versioduo/sax/hardware/sax/sax.pdf

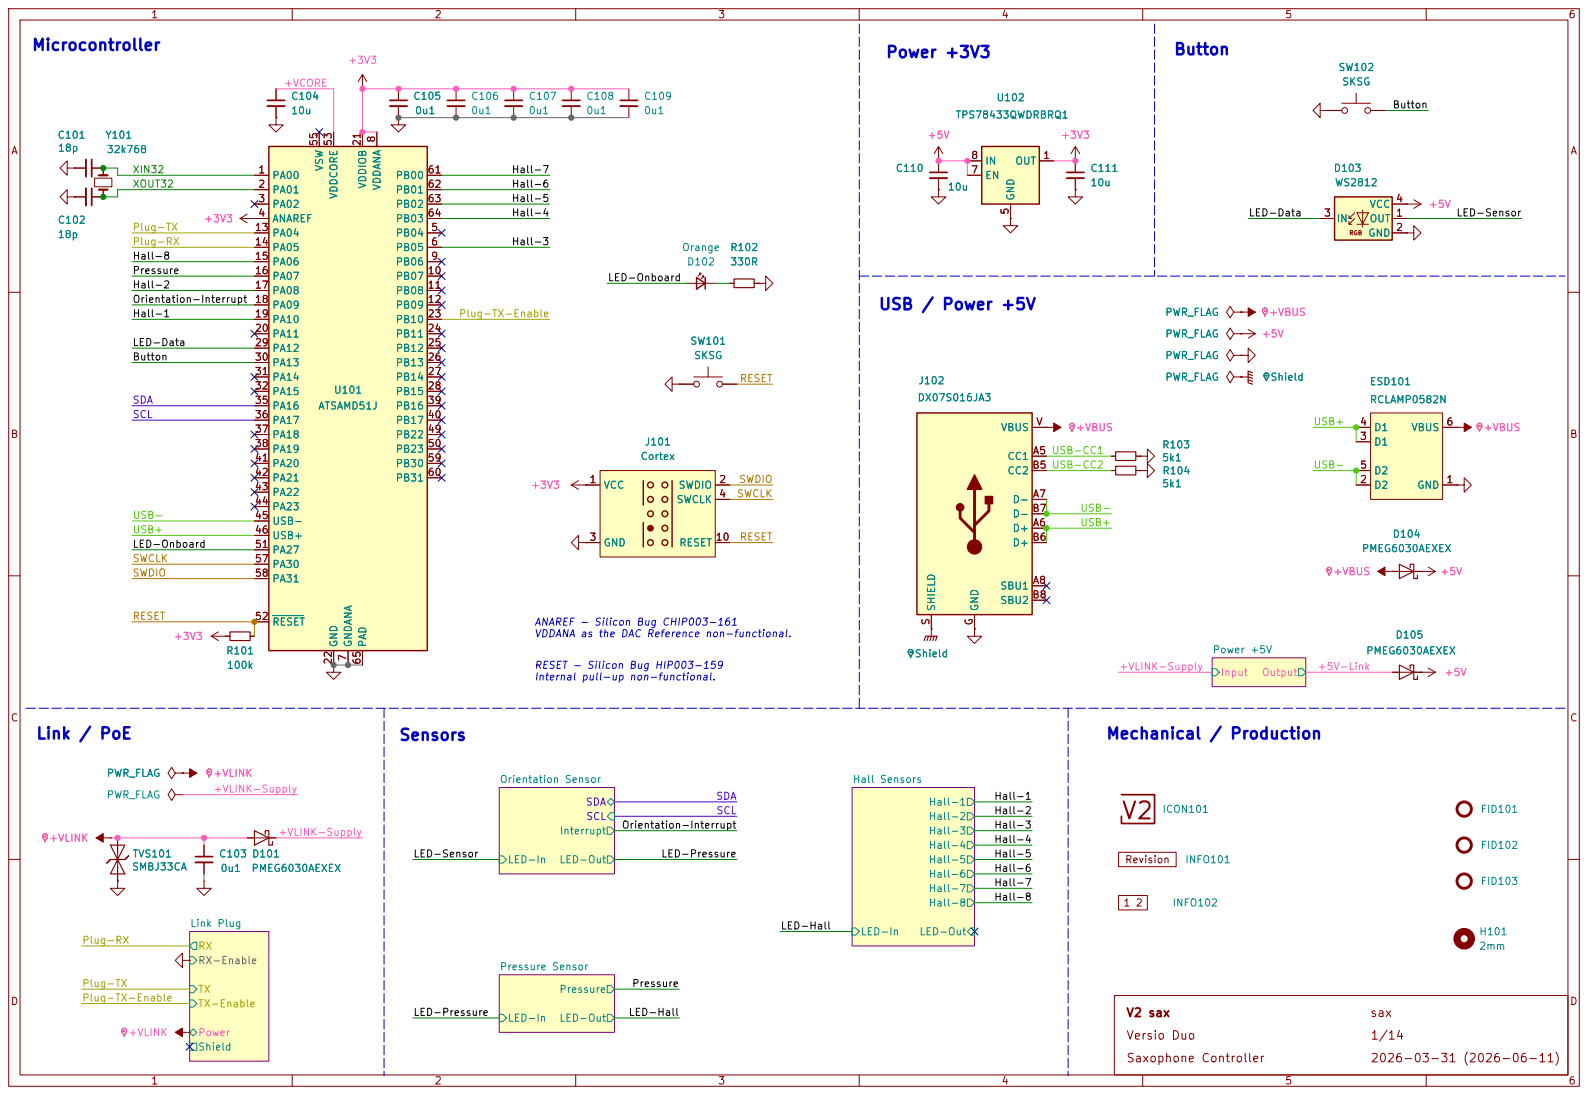
[picture p1: page 1]

LED-Data Plug-RX

VDDANA as the DAC Reference non-functional. Sensors

Internal pull-up non-functional. Link / PoE

TX-Enable Power Shield

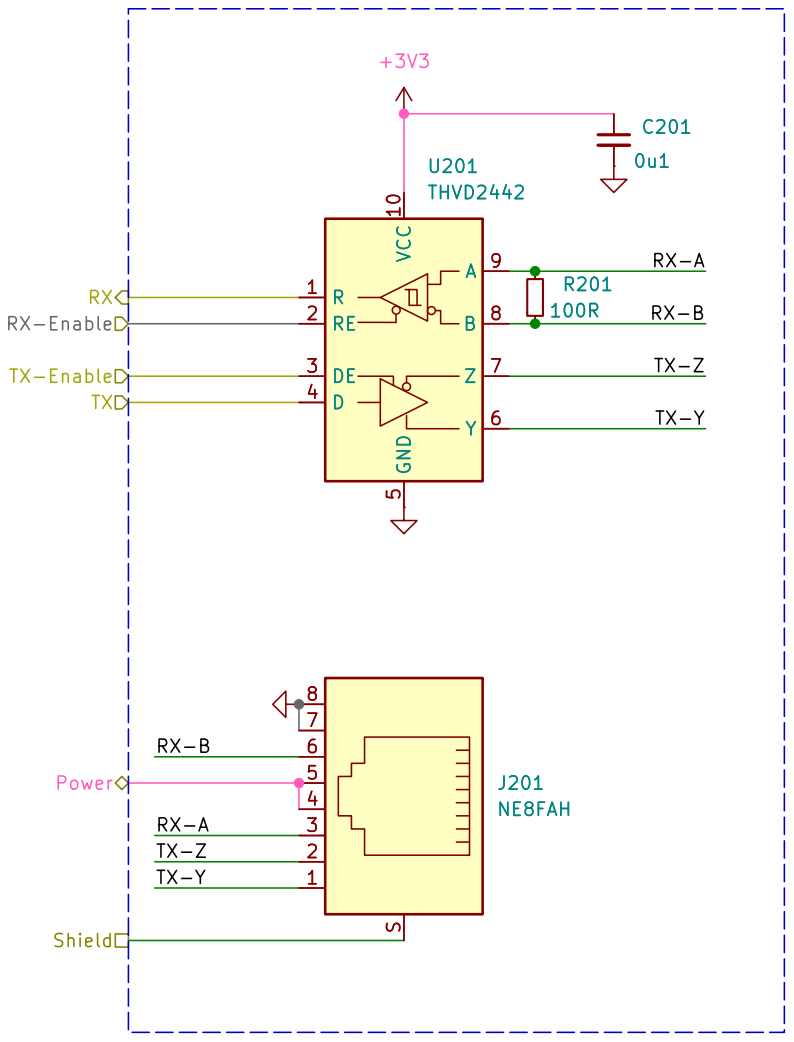
[picture p2: page 2]

0u1 RX-Enable Power TX-Enable RX

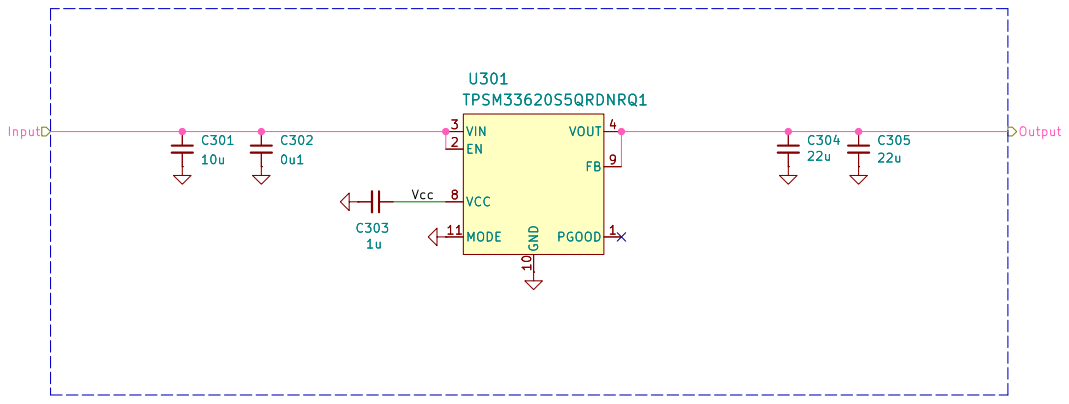
[picture p3: page 3]

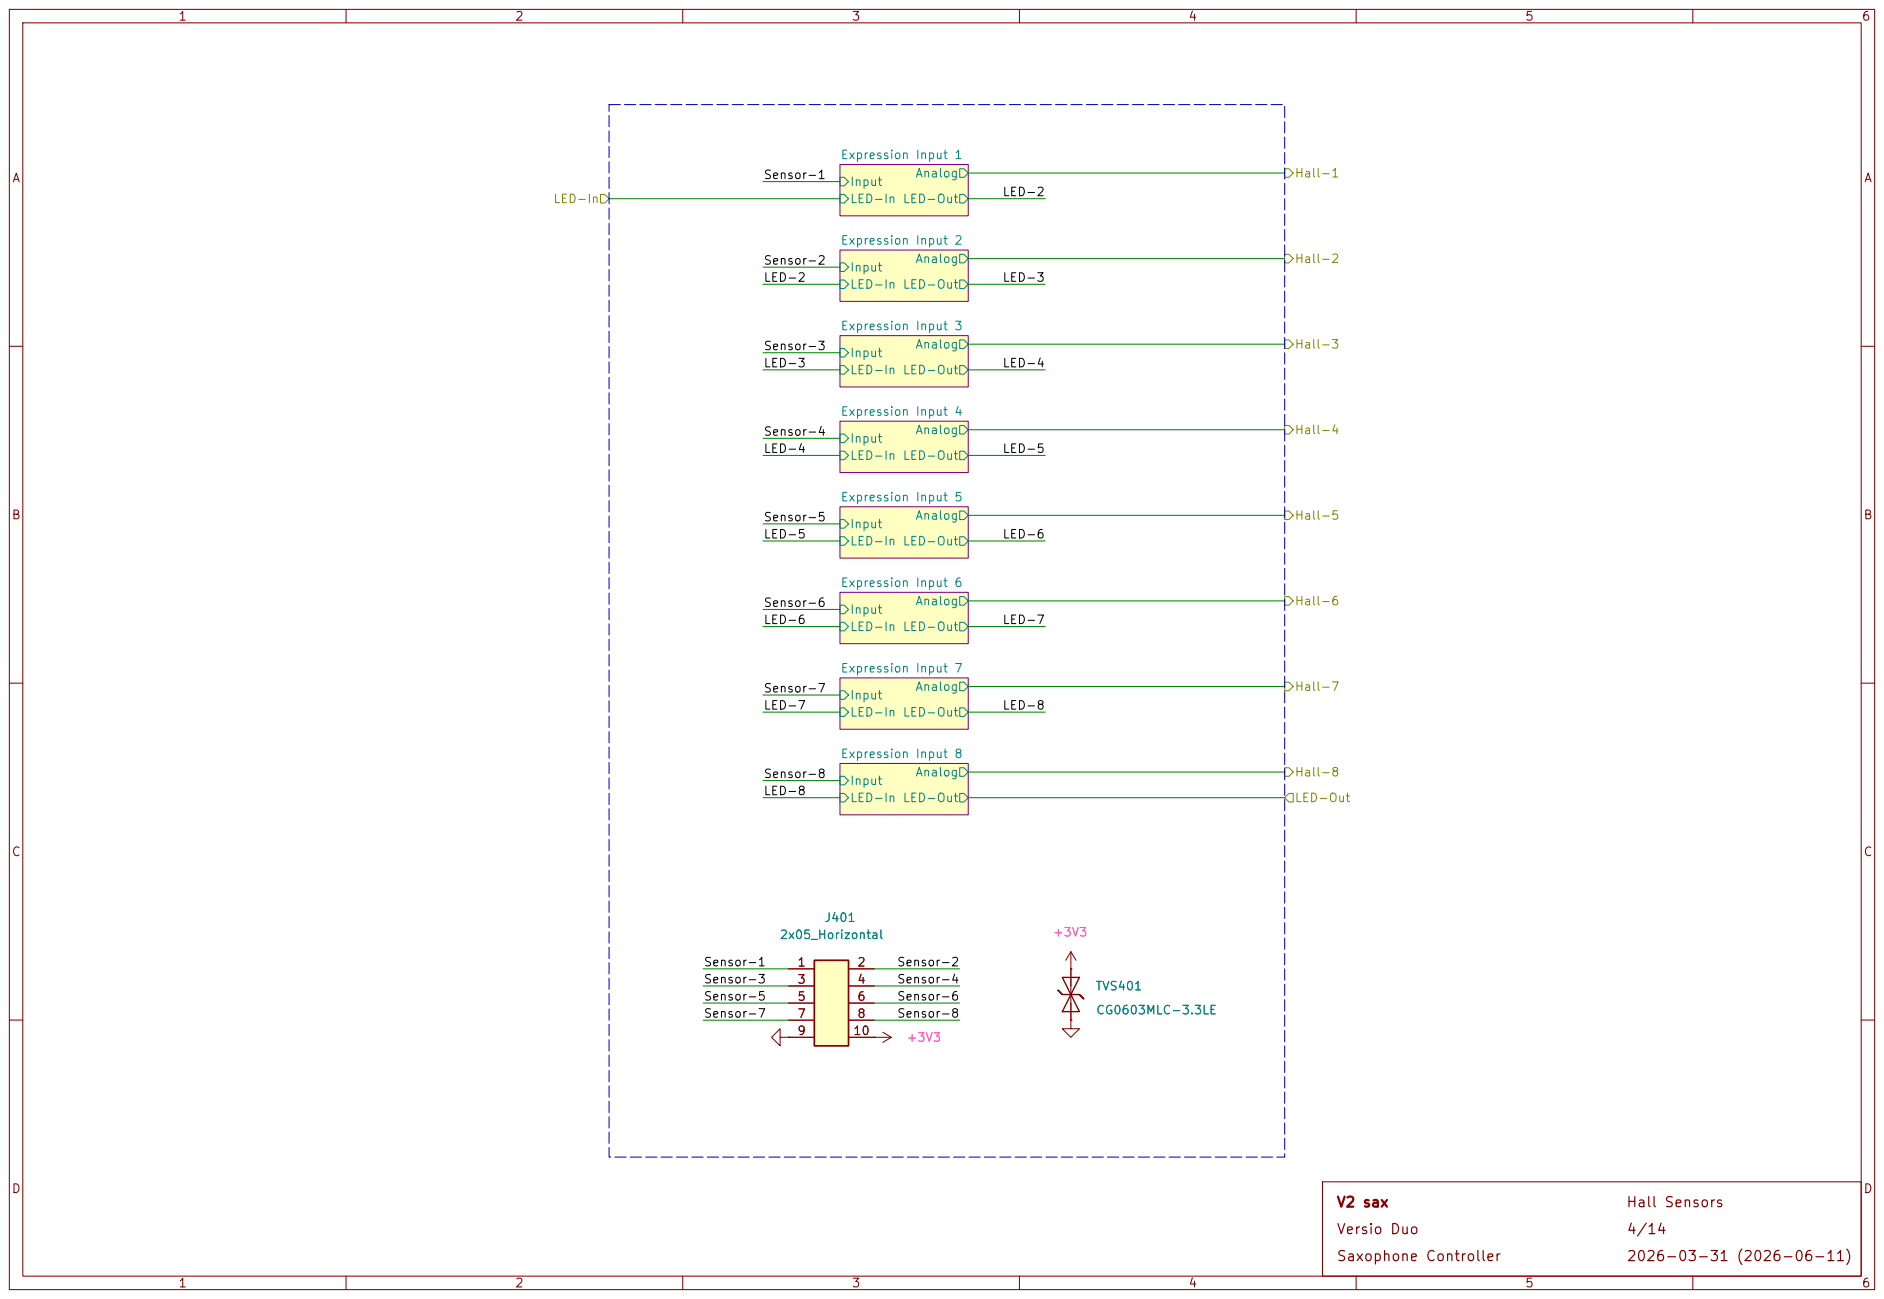
[picture p4: page 4]

Expression Input 1
LED-In LED-Out Analog Input

LED-Out Hall-8 Hall-7 Hall-2 Hall-3 Hall-1 Hall-6 Hall-5 Hall-4

Expression Input 2

Expression Input 3

Expression Input 4

Expression Input 5

Expression Input 7

Expression Input 8

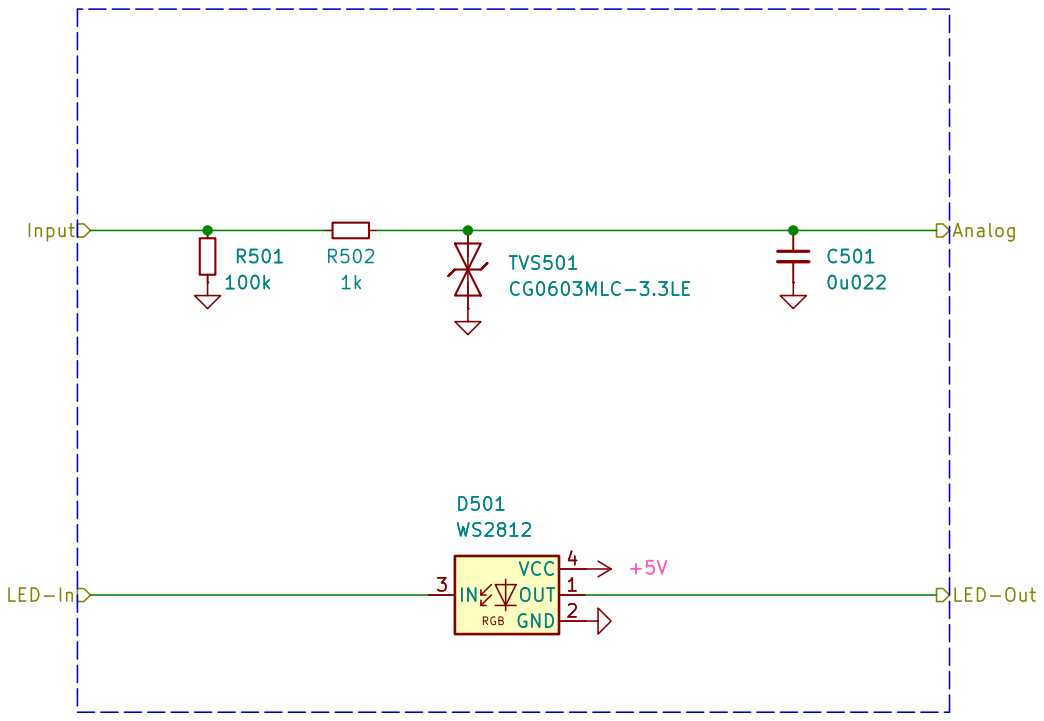
[picture p5: page 5]

TVS501 CG0603MLC-3.3LE +5V D501 WS2812OUT 1 GND 2 VCC 4 D501 WS2812

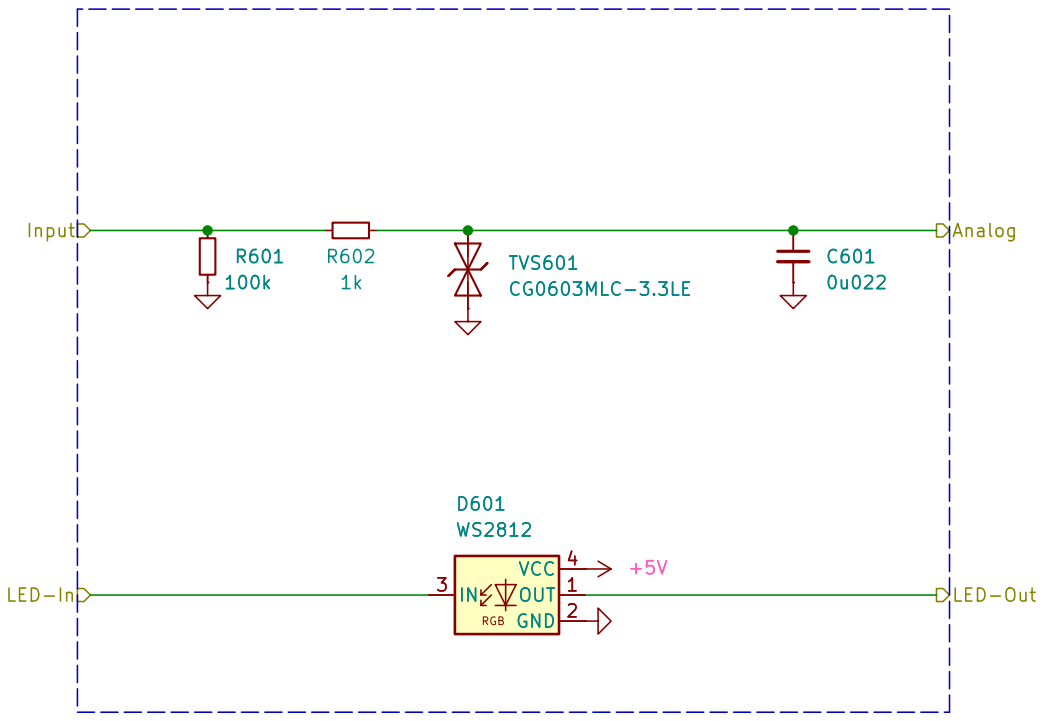
[picture p6: page 6]

TVS601 CG0603MLC-3.3LE D601 WS2812OUT 1 GND 2 VCC 4 D601 WS2812

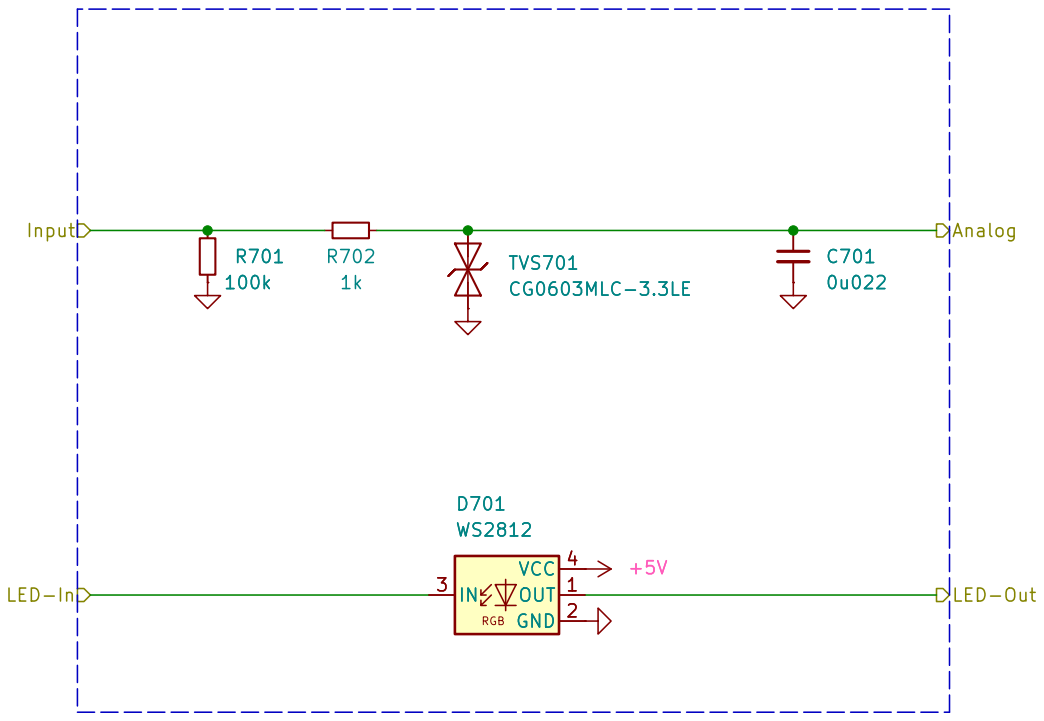
[picture p7: page 7]

TVS701 CG0603MLC-3.3LE +5V D701 WS2812OUT 1 GND 2 VCC 4 D701 WS2812

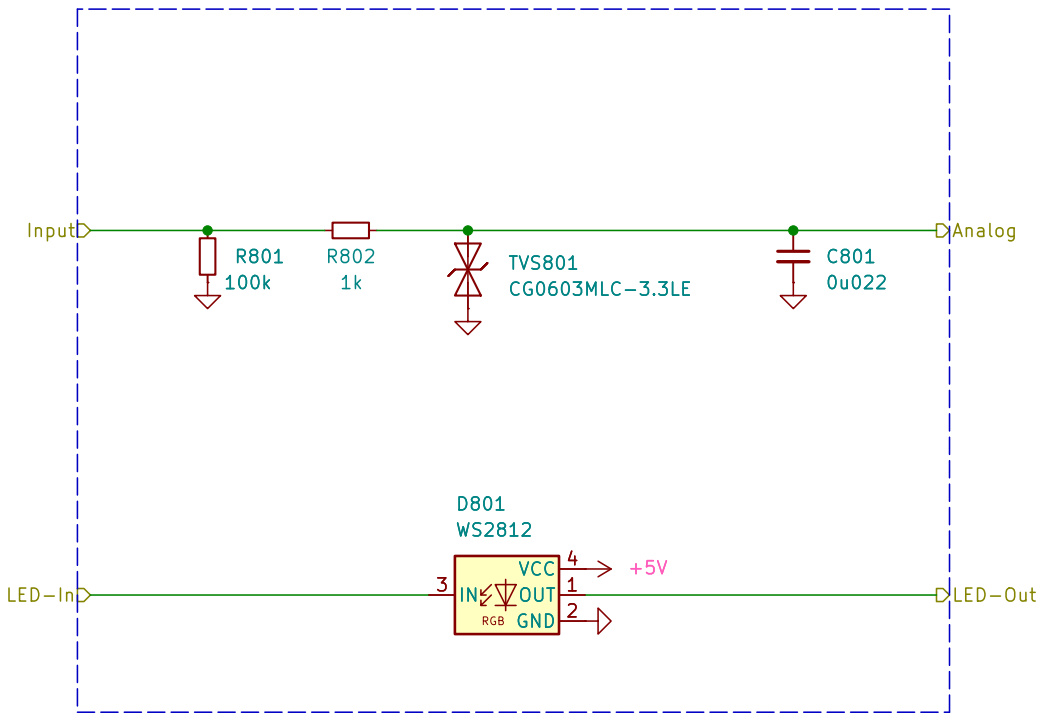
[picture p8: page 8]

TVS801 CG0603MLC-3.3LE +5V D801 WS2812OUT 1 GND 2 VCC 4 D801 WS2812

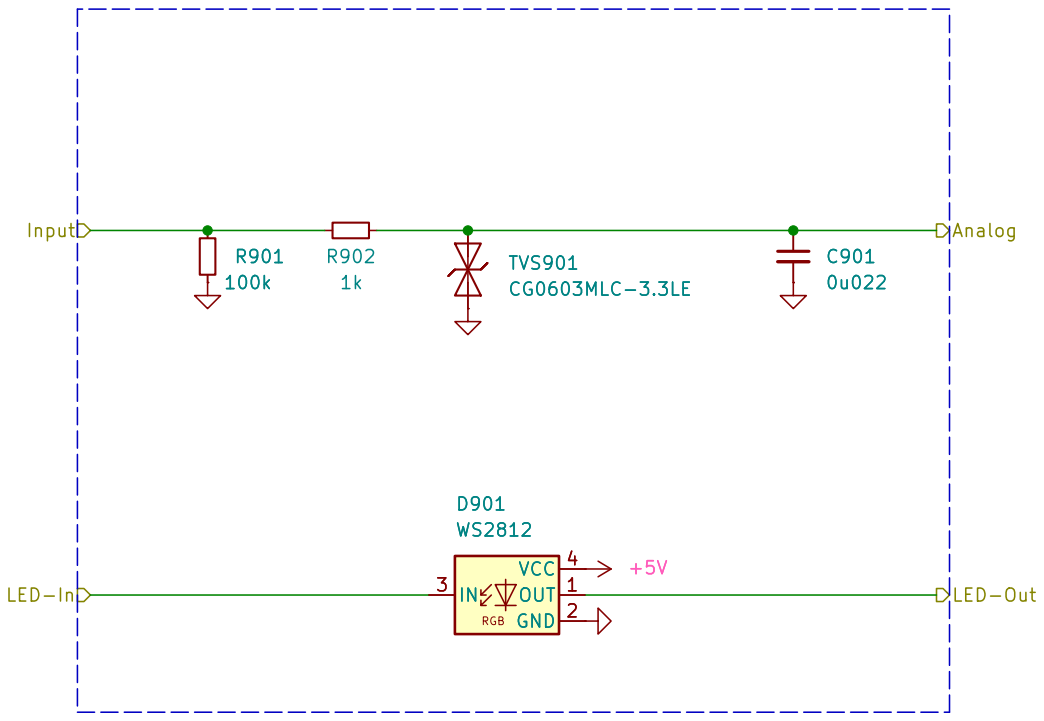
[picture p9: page 9]

TVS901 CG0603MLC-3.3LE +5V D901 WS2812OUT 1 GND 2 VCC 4 D901 WS2812

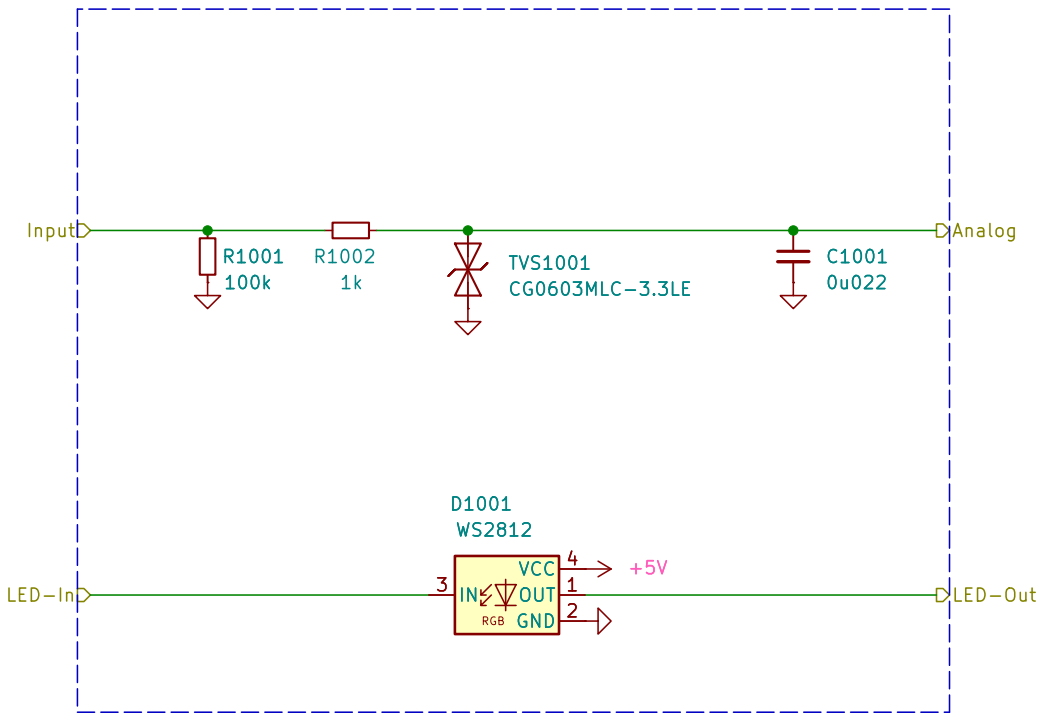
[picture p10: page 10]

TVS1001 CG0603MLC-3.3LE D1001 WS2812OUT 1 GND 2 VCC 4 D1001 WS2812

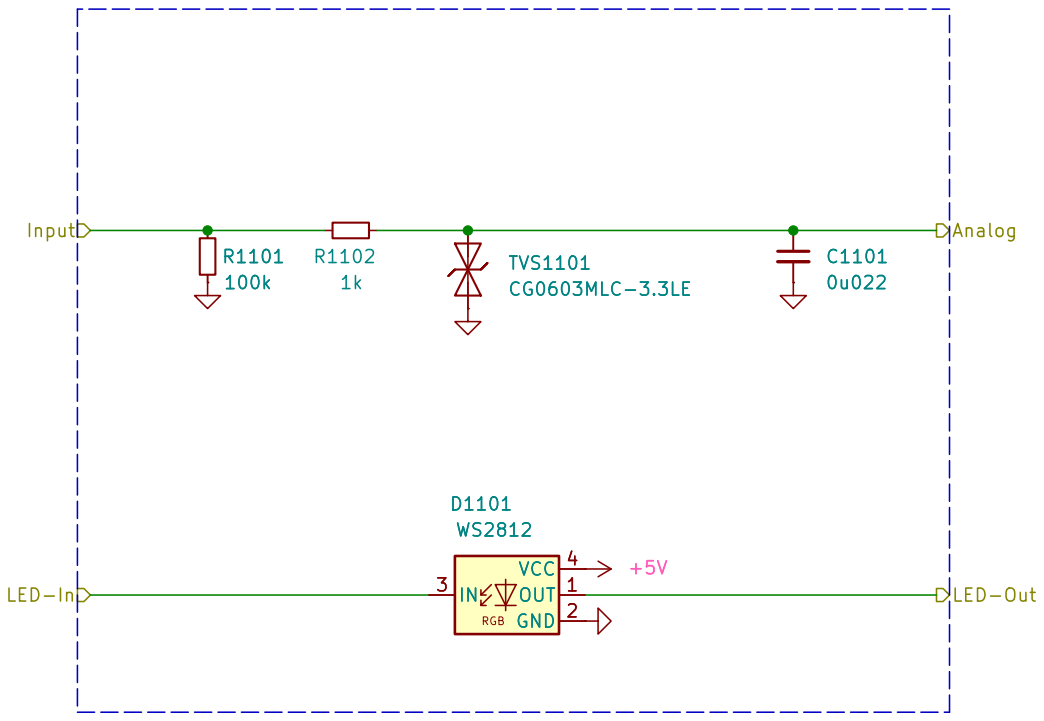
[picture p11: page 11]

TVS1101 CG0603MLC-3.3LE +5V D1101 WS2812OUT 1 GND 2 VCC 4 D1101 WS2812

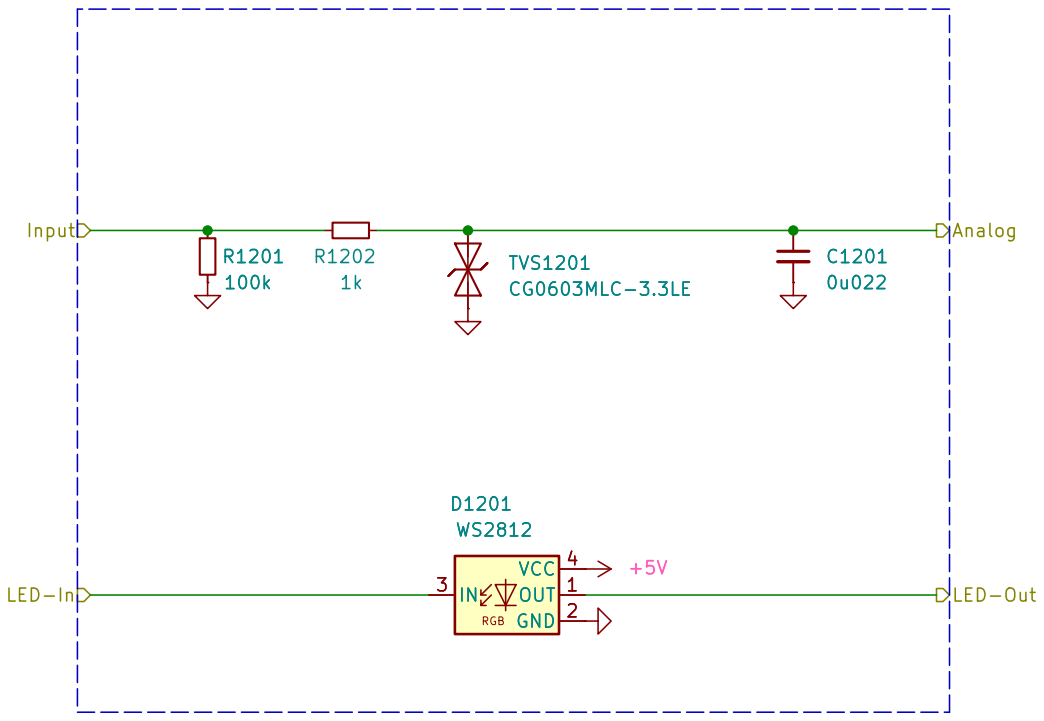
[picture p12: page 12]

TVS1201 CG0603MLC-3.3LE +5V D1201 WS2812OUT 1 GND 2 VCC 4 D1201 WS2812

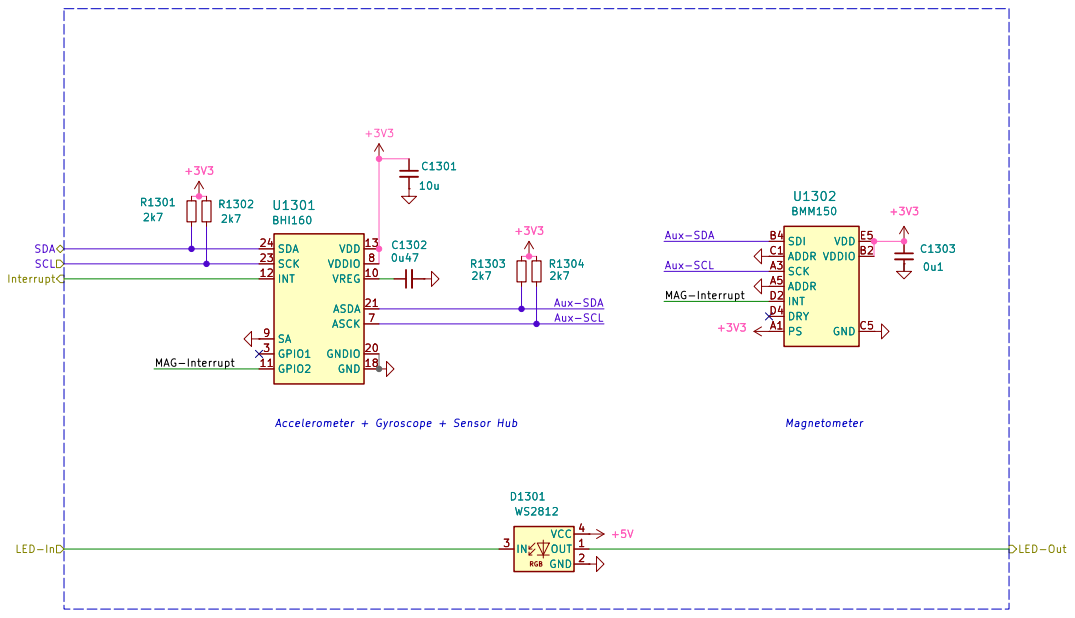
[picture p13: page 13]

MAG-Interrupt Aux-SCL Aux-SDA

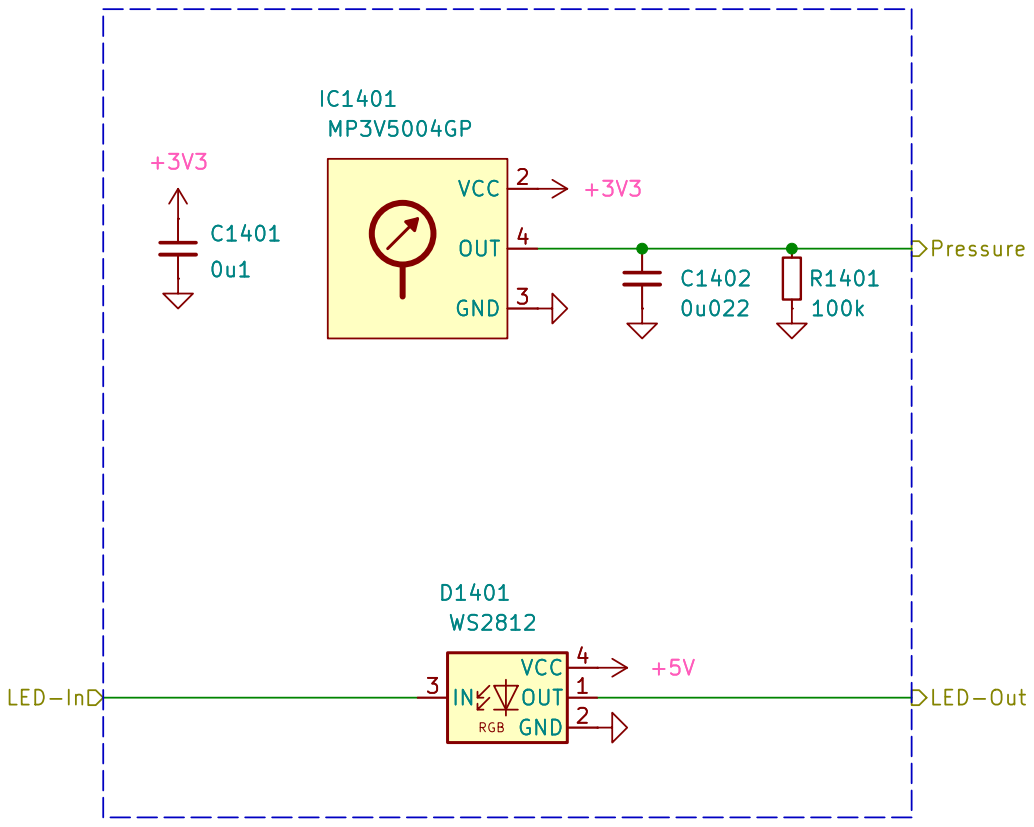
[picture p14: page 14]
