versioduo/sax/hardware/sensor-1/sensor-1.pdf

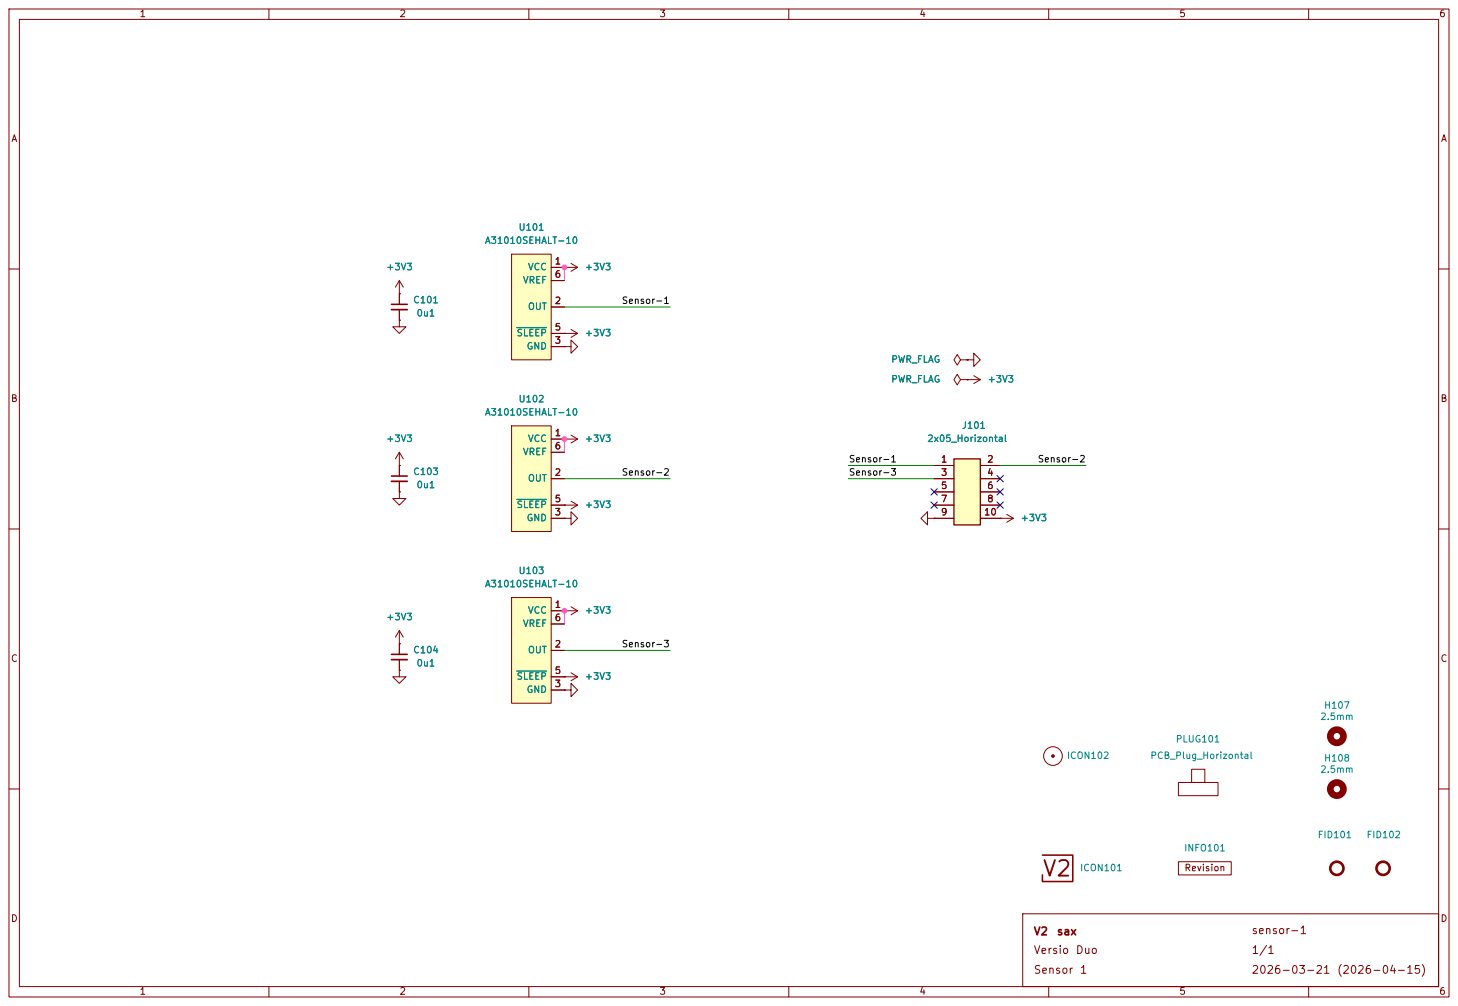
[picture p15: page 1]
