versioduo/sax/hardware/sensor-2/sensor-2.pdf

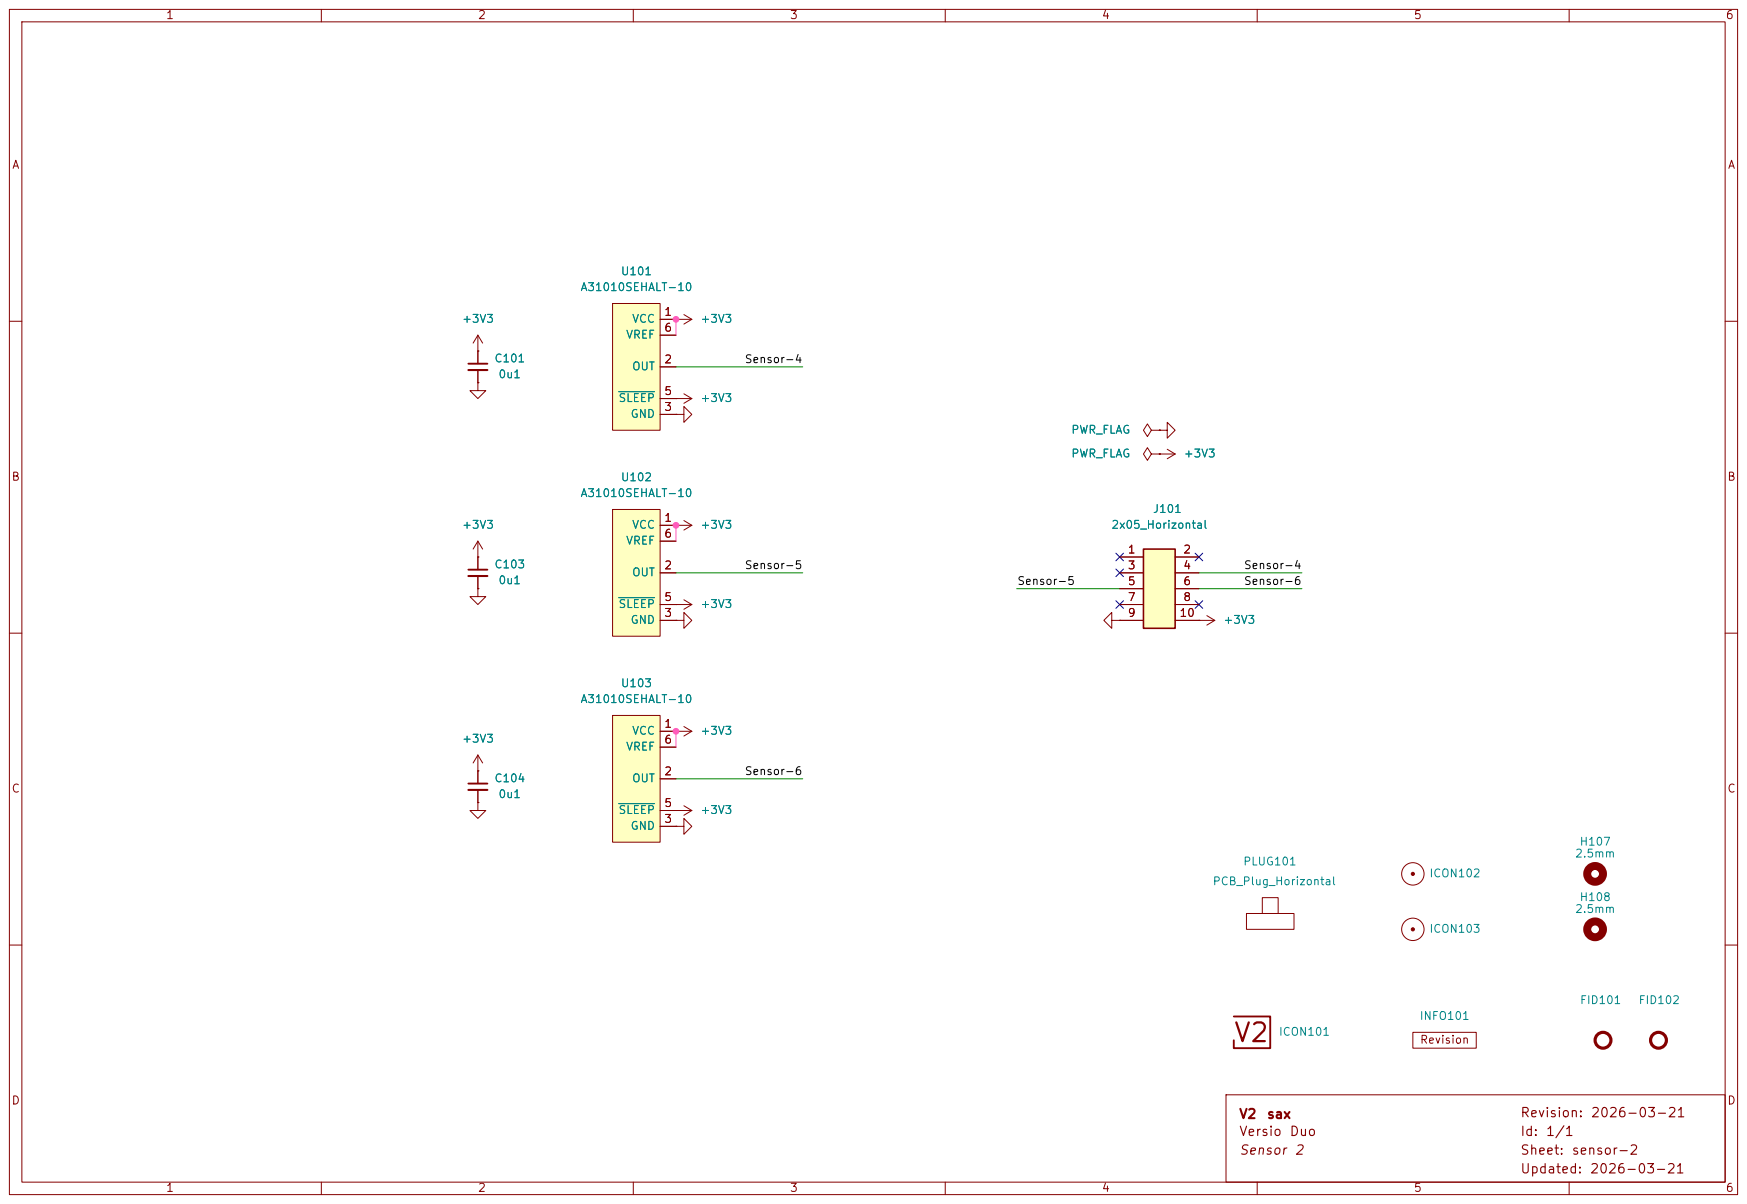
[picture p16: page 1]
