versioduo/sax/hardware/sensor-3/sensor-3.pdf

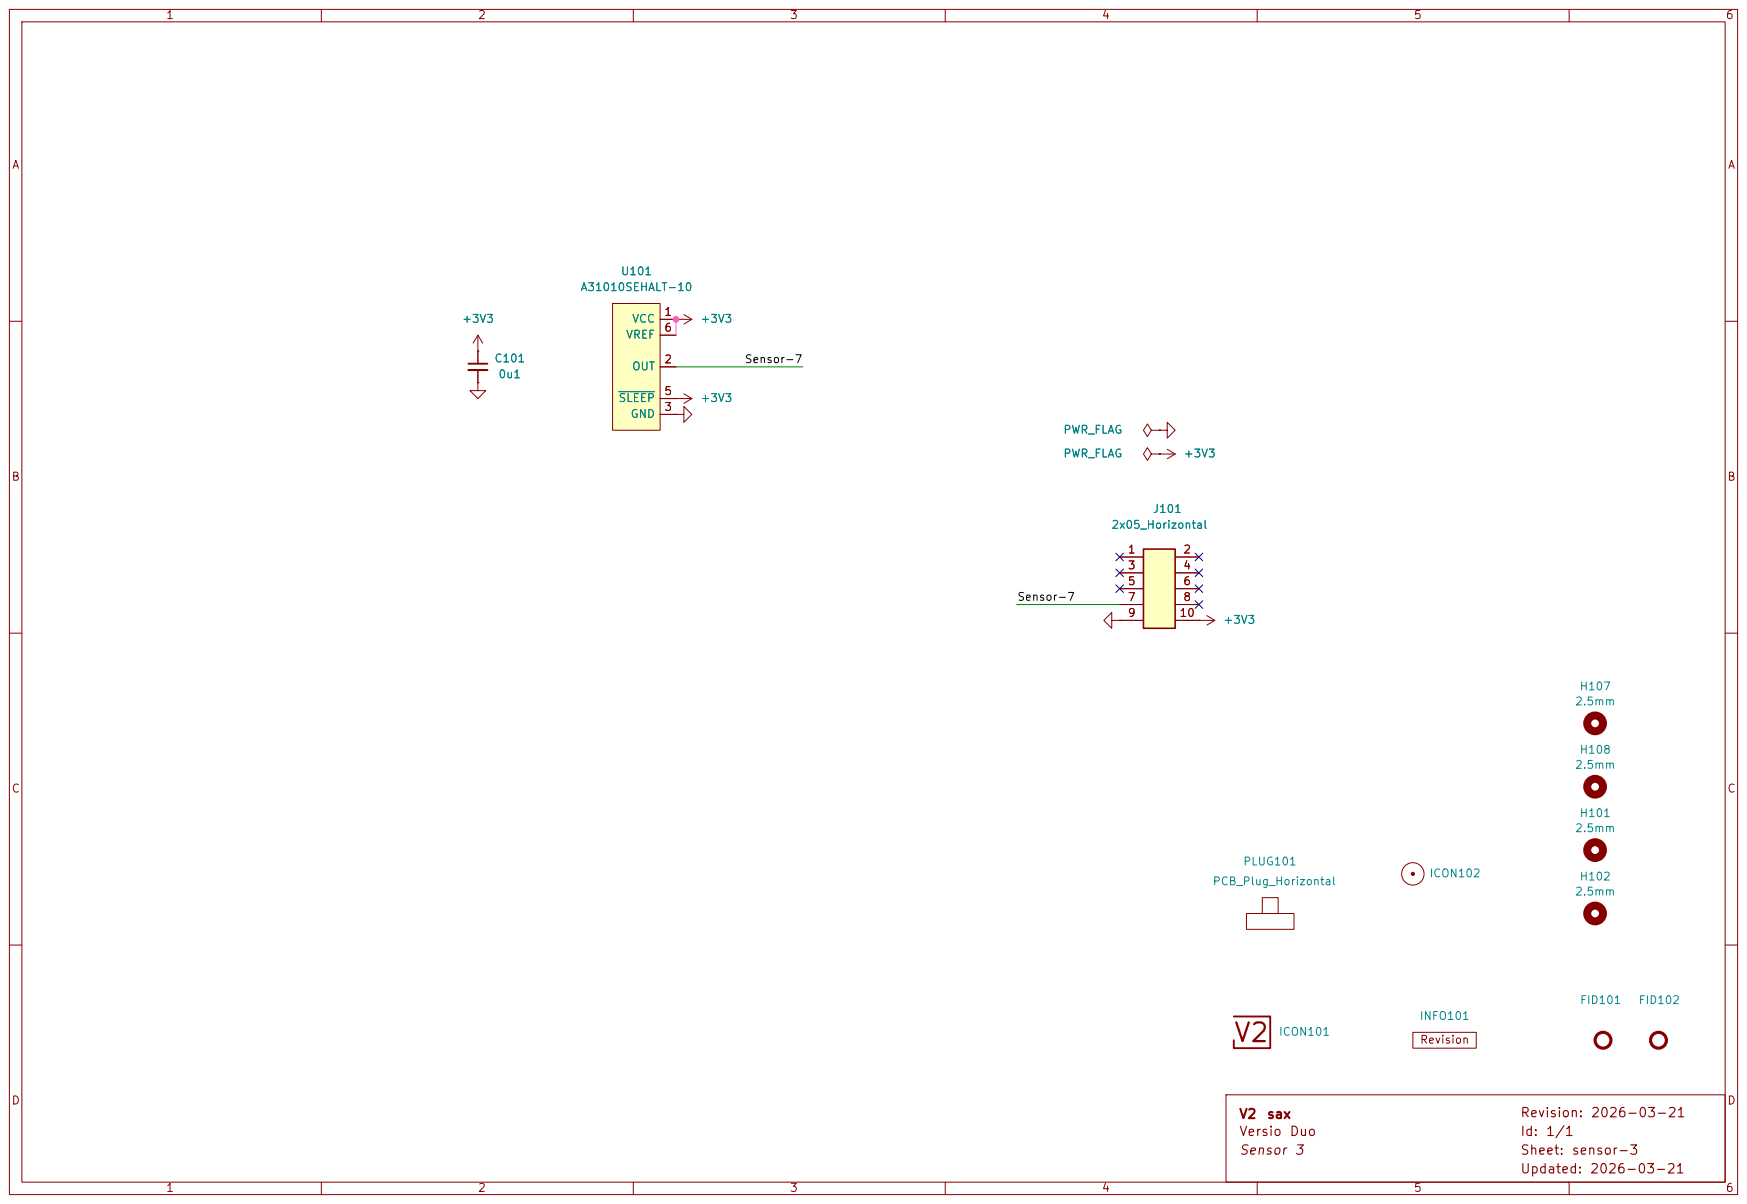
[picture p17: page 1]
