versioduo/sax/hardware/sensor-4/sensor-4.pdf

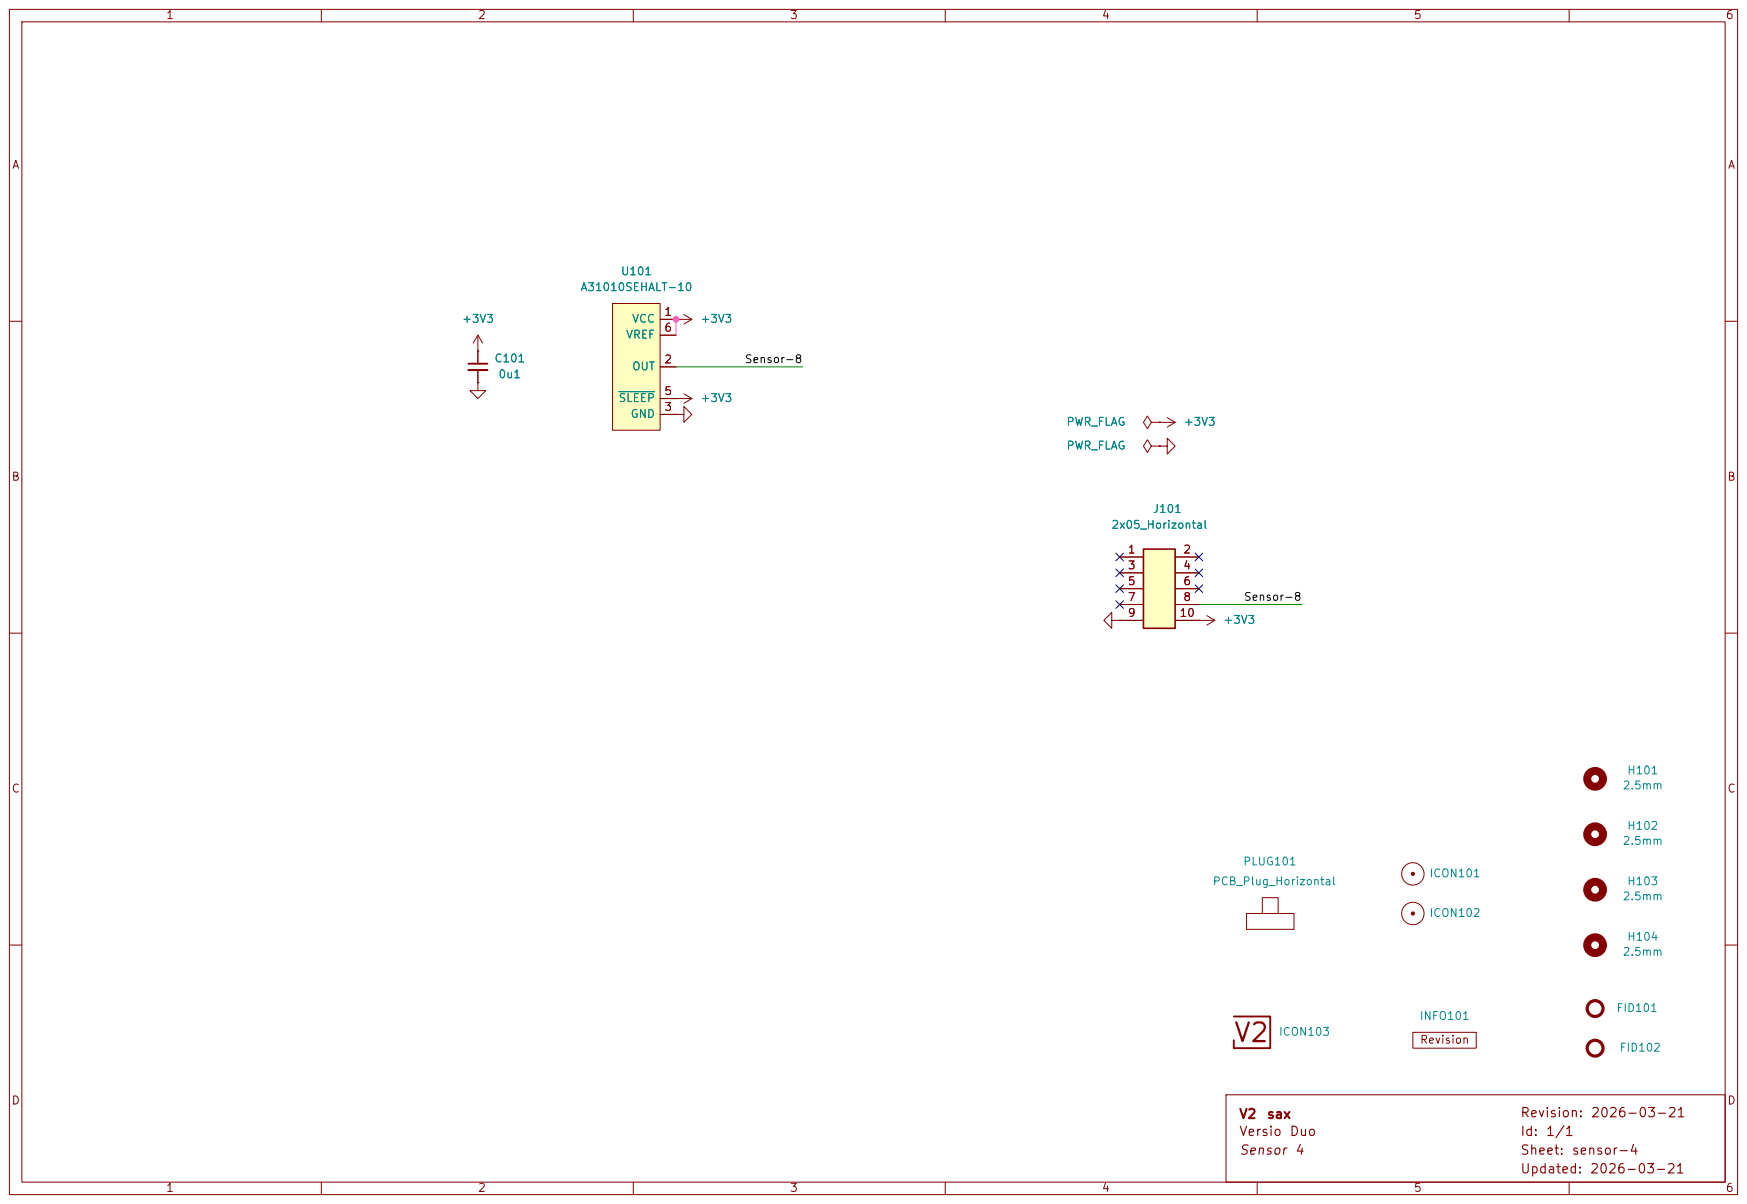
[picture p18: page 1]
