versioduo/sax/hardware/sax/sax.kicad_pcb

## KiCad design hardware/sax/sax.kicad_pcb (2026-06-11)

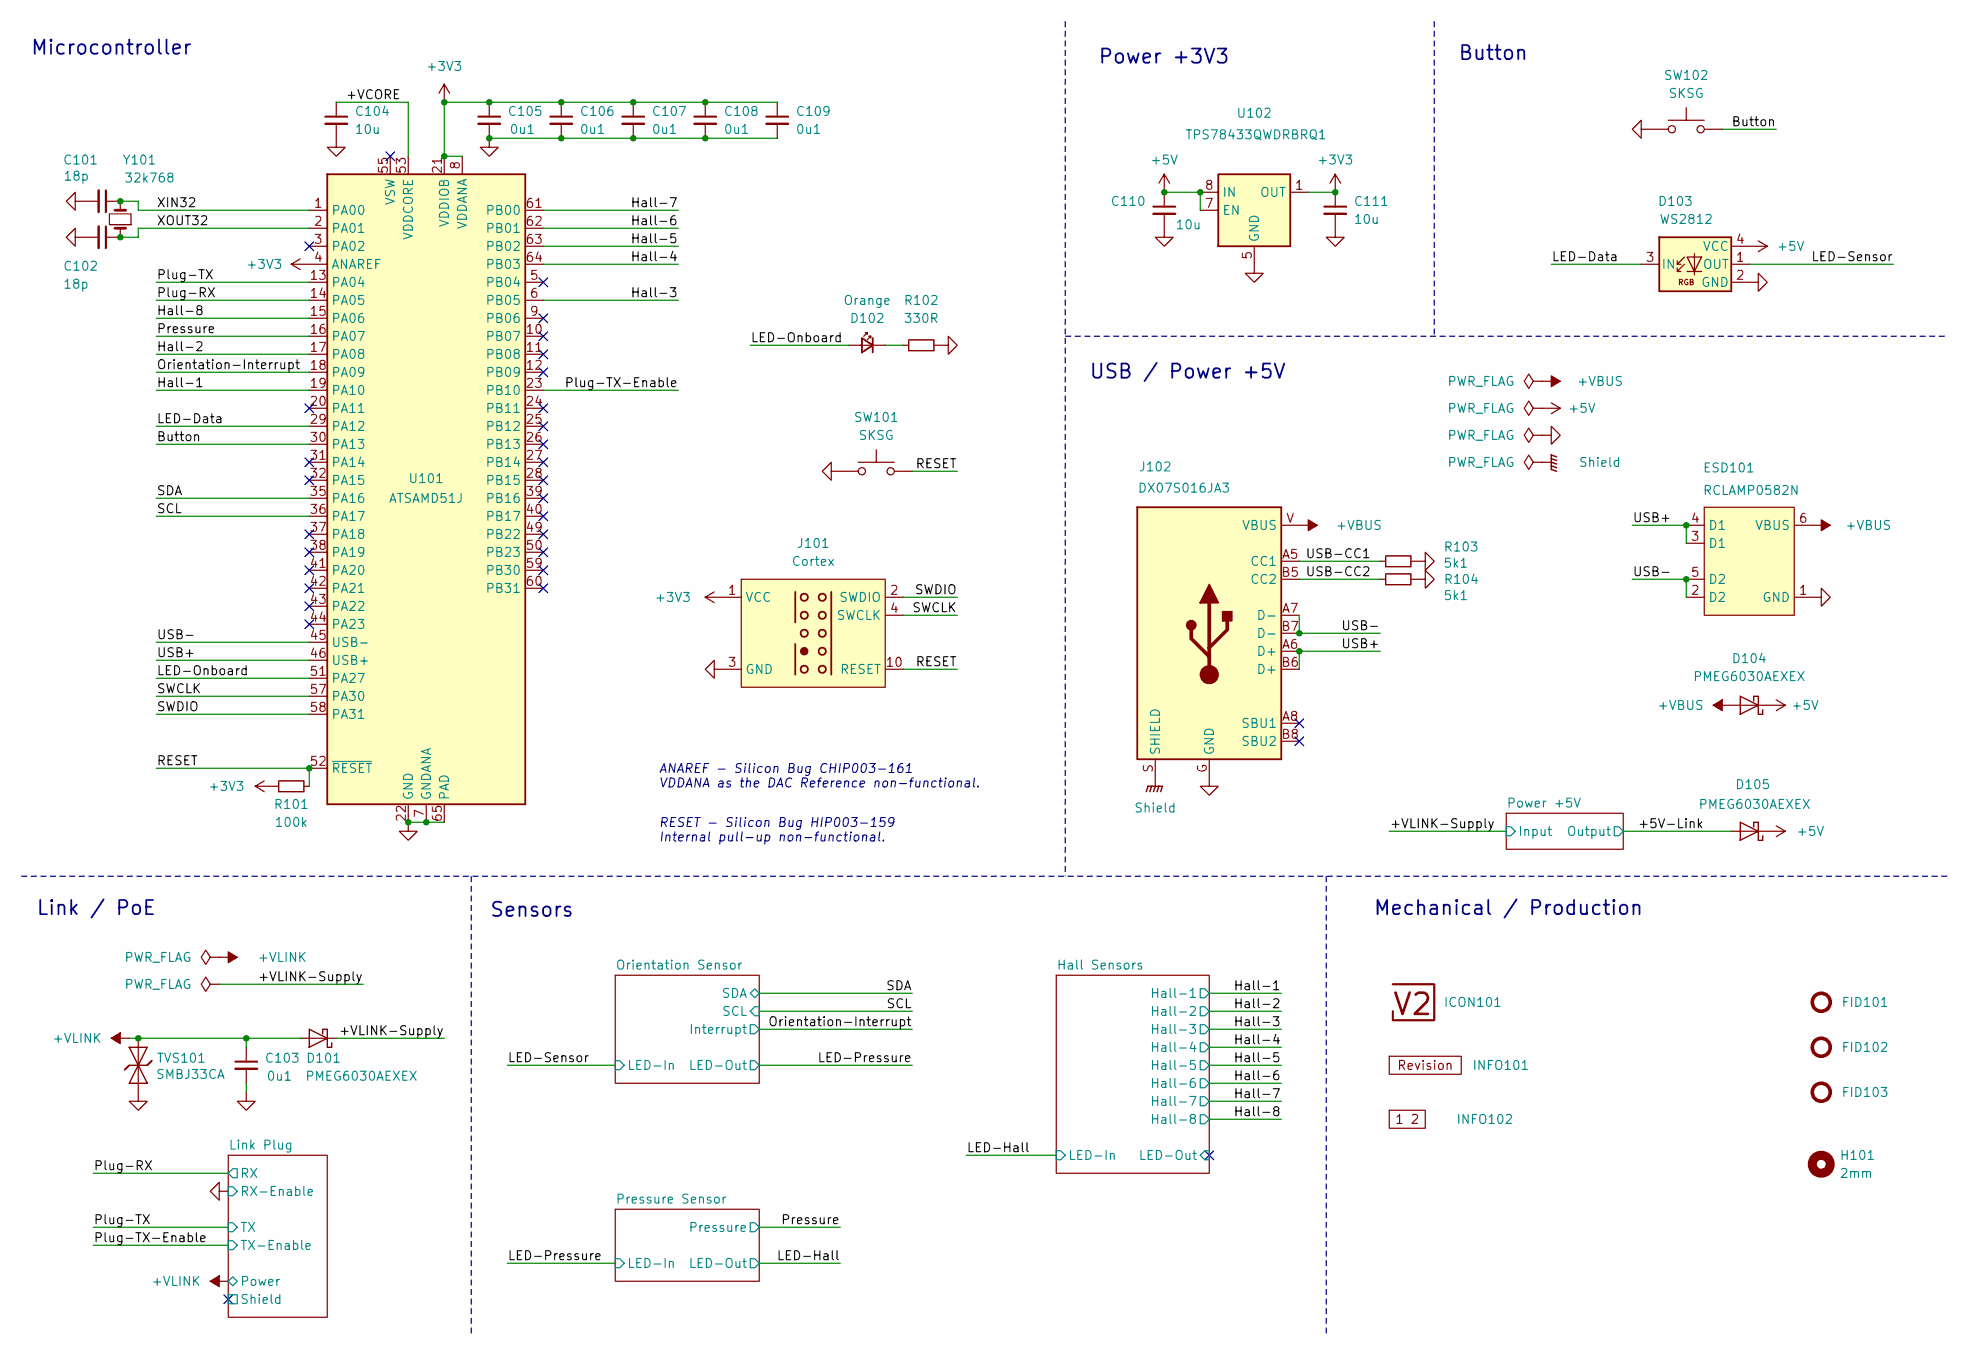
[picture p19: schematic sax.kicad_sch, V2 sax]

Parts:
C101, C102: 18p; C_1608; Rating 50V; Mouser 810-CGA3E2C0G1H180J
C103, C105, C106, C107, C108, C109: 0u1; C_1608; Rating 50V; Mouser 810-CGA3E2X7R1H104MA
C104: 10u; C_1608; Rating 10V; Mouser 810-C1608X6S1A106M
C110, C111: 10u; C_2012; Rating 25V; Mouser 810-C2012X5R1E106K
D101, D104, D105: PMEG6030AEXEX; D_SOD-123HP; Rating 60V; Mouser 771-PMEG6030AEXEX
D102: Orange; LED_1608; Rating 605nm; Mouser 755-SML-D12D1WT86
D103: WS2812; WS2812-2020; Rating 15mA; LCSC C965555
ESD101: RCLAMP0582N; SLP1210N6; Rating 20kV; Mouser 947-RCLAMP0582N.TCT
FID101, FID102, FID103: Fiducial_Paste; Fiducial_0.5mm_Mask1mm_Paste
H101: 2mm; MountingHole_2mm
ICON101: V2-logo; Logo_Small
INFO101: Revision
INFO102: Layer_Numbers-4
J101: Cortex
J102: DX07S016JA3; JAE_DX07S016JA3; Rating USB2.0; Mouser 656-DX07S016JA3R1500
R101: 100k; R_1608; Rating 100mW; Mouser 71-CRCW0603100KFKEAC
R102: 330R; R_1608; Rating 100mW; Mouser 71-CRCW0603330RFKEAC
R103, R104: 5k1; R_1608; Rating 100mW; Mouser 71-CRCW06035K10FKEAC
SW101, SW102: SKSG; Rating 1.6N; Mouser 688-SKSGACE010
TVS101: SMBJ33CA; D_SMB; Rating 33V; Mouser 652-SMBJ33CA-Q
U101: ATSAMD51J; QFN-64-1EP_9x9mm_P0.5mm_EP4.8x4.8mm_ThermalVias; Rating Cortex-M4F; Mouser 556-ATSAMD51J19AMU
U102: TPS78433QWDRBRQ1; VSON-8-1_3x3mm_P0.65_EP1.65x2.4mm; Rating 300mA; Mouser 595-TPS78433QWDRBRQ1
Y101: 32k768; Crystal_SMD_3215-2Pin_3.2x1.5mm; Rating 10ppm; Mouser 815-ABS0716632.768KT

Connections:
+3V3: C105.1, C106.1, C107.1, C108.1, C109.1, C111.1, J101.1 (VCC), R101.1, U101.4 (ANAREF), U101.8 (VDDANA), U101.21 (VDDIOB), U101.34 (VDDIO), U101.48 (VDDIO), U101.56 (VDDIO), U102.1 (OUT); also elsewhere on the board
+5V: C110.1, D103.4 (VCC), D104.1 (K), D105.1 (K), U102.7 (EN), U102.8 (IN); also elsewhere on the board
/+5V-Link: D105.2 (A); also elsewhere on the board
/+VBUS: D104.2 (A), ESD101.6 (VBUS), J102.V (VBUS)
/+VCORE: C104.1, U101.53 (VDDCORE)
/+VLINK: C103.1, D101.2 (A), TVS101.2 (A); also elsewhere on the board
/+VLINK-Supply: D101.1 (K); also elsewhere on the board
/Button: SW102.2, U101.30 (PA13)
/Hall-1: U101.19 (PA10); also elsewhere on the board
/Hall-2: U101.17 (PA08); also elsewhere on the board
/Hall-3: U101.6 (PB05); also elsewhere on the board
/Hall-4: U101.64 (PB03); also elsewhere on the board
/Hall-5: U101.63 (PB02); also elsewhere on the board
/Hall-6: U101.62 (PB01); also elsewhere on the board
/Hall-7: U101.61 (PB00); also elsewhere on the board
/Hall-8: U101.15 (PA06); also elsewhere on the board
/LED-Data: D103.3 (IN), U101.29 (PA12)
/LED-Onboard: D102.2 (A), U101.51 (PA27)
/LED-Sensor: D103.1 (OUT); also elsewhere on the board
/Orientation-Interrupt: U101.18 (PA09); also elsewhere on the board
/Plug-RX: U101.14 (PA05); also elsewhere on the board
/Plug-TX: U101.13 (PA04); also elsewhere on the board
/Plug-TX-Enable: U101.23 (PB10); also elsewhere on the board
/Pressure: U101.16 (PA07); also elsewhere on the board
/RESET: J101.10 (RESET), R101.2, SW101.2, U101.52 (~RESET)
/SCL: U101.36 (PA17); also elsewhere on the board
/SDA: U101.35 (PA16); also elsewhere on the board
/SWCLK: J101.4 (SWCLK), U101.57 (PA30)
/SWDIO: J101.2 (SWDIO), U101.58 (PA31)
/Shield: J102.S (SHIELD)
/USB+: ESD101.3 (D1), ESD101.4 (D1), J102.A6 (D+), J102.B6 (D+), U101.46 (USB+)
/USB-: ESD101.2 (D2), ESD101.5 (D2), J102.A7 (D-), J102.B7 (D-), U101.45 (USB-)
/USB-CC1: J102.A5 (CC1), R103.1
/USB-CC2: J102.B5 (CC2), R104.1
/XIN32: C101.1, U101.1 (PA00), Y101.2
/XOUT32: C102.1, U101.2 (PA01), Y101.1
GND: C101.2, C102.2, C103.2, C104.2, C105.2, C106.2, C107.2, C108.2, C109.2, C110.2, C111.2, D103.2 (GND), ESD101.1 (GND), J101.3 (GND), J101.5 (GND), J102.G (GND), R102.2, R103.2, R104.2, SW101.1, SW102.1, TVS101.1 (K), U101.7 (GNDANA), U101.22 (GND), U101.33 (GND), U101.47 (GND), U101.54 (GND), U101.65 (PAD), U102.5 (GND), U102.9 (GND); also elsewhere on the board
unnamed: D102.1 (K), R102.1

Notes on the sheet:
ANAREF - Silicon Bug CHIP003-161 VDDANA as the DAC Reference non-functional.
Sensors
Link / PoE
RESET - Silicon Bug HIP003-159 Internal pull-up non-functional.
Button
Power +3V3
Mechanical / Production
Microcontroller
USB / Power +5V

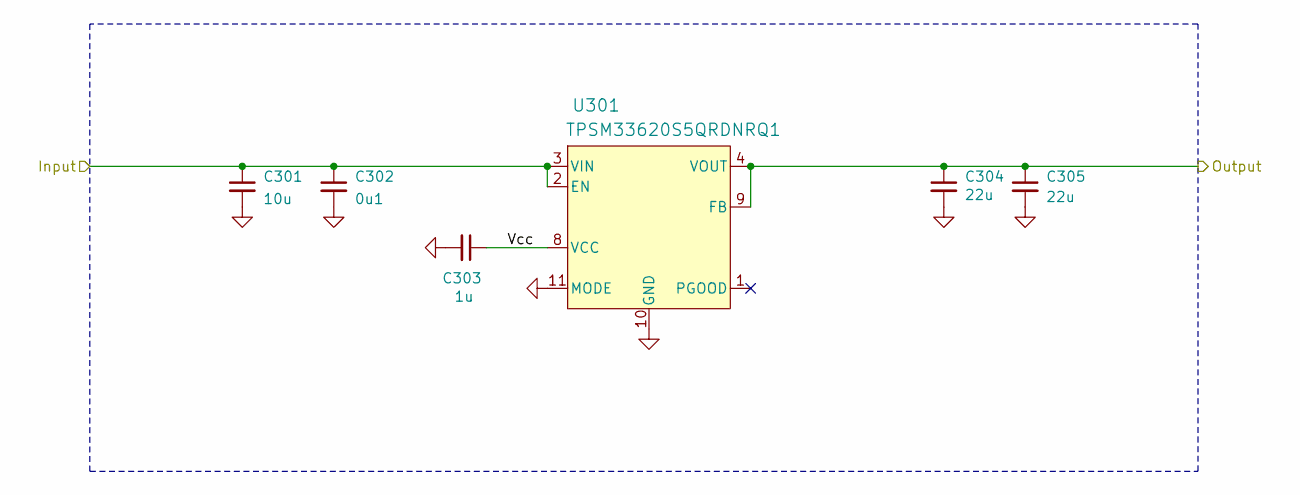
[picture p20: schematic PowerSupply.kicad_sch, V2 sax]

Parts:
C301: 10u; C_3225; Rating 50V; Mouser 810-CNC6P1X7R1H106K2
C302: 0u1; C_1608; Rating 50V; Mouser 810-CGA3E2X7R1H104MA
C303: 1u; C_1608; Rating 50V; Mouser 810-CGA3E3X7R1H105K0
C304, C305: 22u; C_3225; Rating 25V; Mouser 810-CGA6P3X7R1E226M5
U301: TPSM33620S5QRDNRQ1; QFN-11; Rating 2A; Mouser 595-SM33620S5QRDNRQ1

Connections:
/+5V-Link: C304.1, C305.1, U301.4 (VOUT), U301.9 (FB); also elsewhere on the board
/+VLINK-Supply: C301.1, C302.1, U301.2 (EN), U301.3 (VIN); also elsewhere on the board
/Power +5V/Vcc: C303.1, U301.8 (VCC)
GND: C301.2, C302.2, C303.2, C304.2, C305.2, U301.10 (GND), U301.11 (MODE); also elsewhere on the board

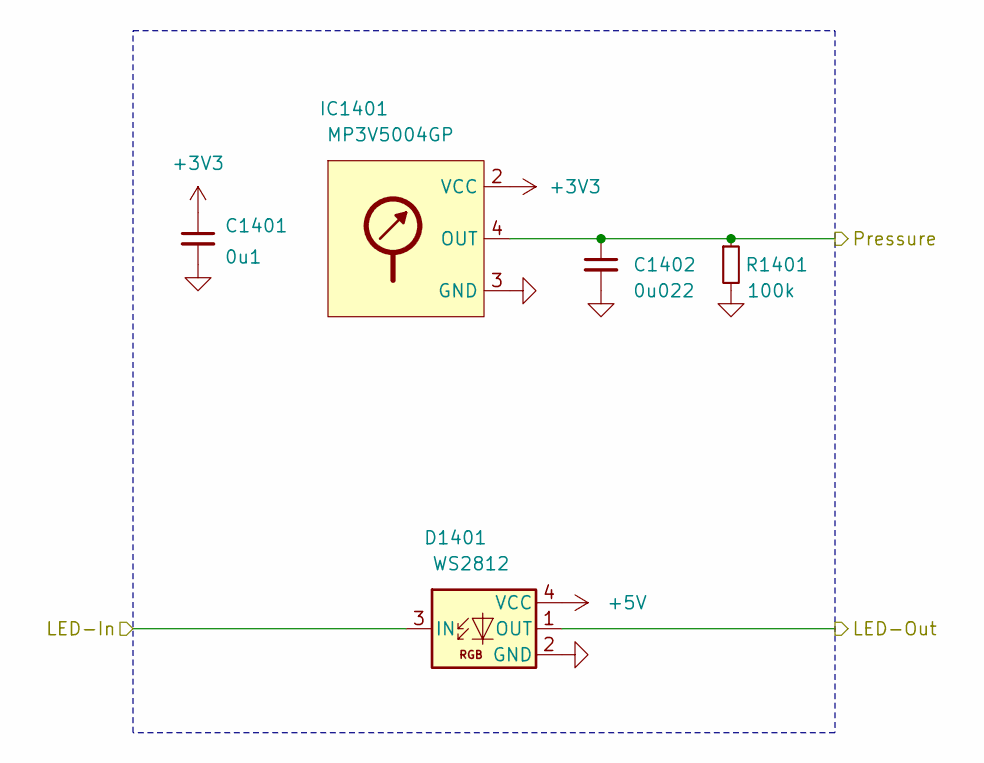
[picture p21: schematic PressureSensor.kicad_sch, V2 sax]

Parts:
C1401: 0u1; C_1608; Rating 50V; Mouser 810-CGA3E2X7R1H104MA
C1402: 0u022; C_1608; Rating 50V; Mouser 603-CC603KPX7R9BB223
D1401: WS2812; WS2812-2020; Rating 15mA; LCSC C965555
IC1401: MP3V5004GP; Rating 3.92 kPa; Mouser 841-MP3V5004GP
R1401: 100k; R_1608; Rating 100mW; Mouser 71-CRCW0603100KFKEAC

Connections:
+3V3: C1401.1, IC1401.2 (VCC); also elsewhere on the board
+5V: D1401.4 (VCC); also elsewhere on the board
/LED-Hall: D1401.1 (OUT); also elsewhere on the board
/LED-Pressure: D1401.3 (IN); also elsewhere on the board
/Pressure: C1402.1, IC1401.4 (OUT), R1401.1; also elsewhere on the board
GND: C1401.2, C1402.2, D1401.2 (GND), IC1401.3 (GND), R1401.2; also elsewhere on the board

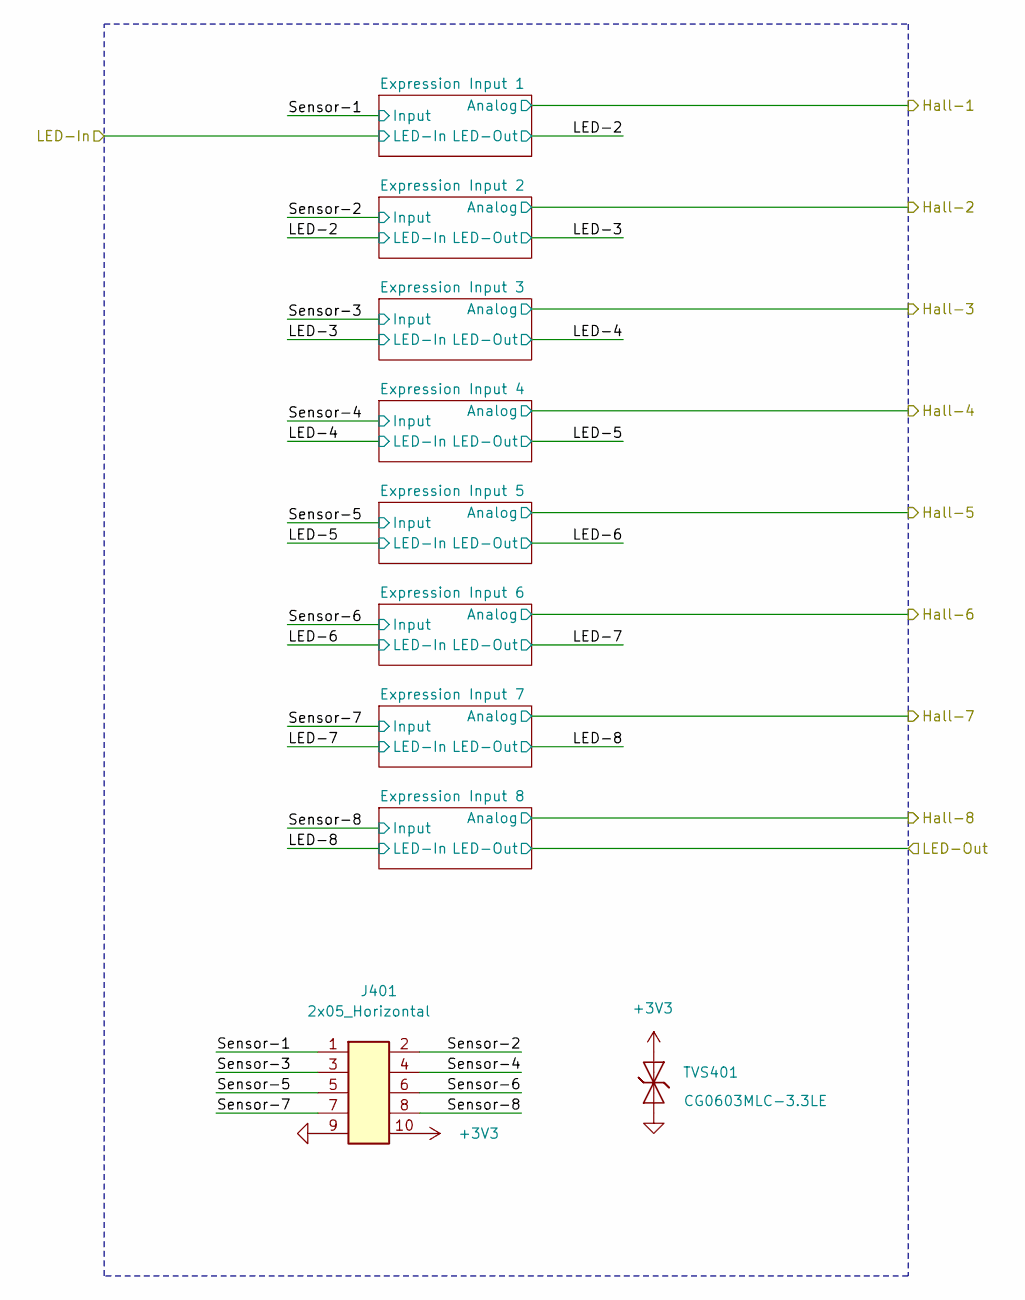
[picture p22: schematic HallSensors.kicad_sch, V2 sax]

Parts:
J401: 2x05_Horizontal; PinHeader_2x05_P1.27mm_Horizontal; Rating 1A; Mouser 649-200211120001T4LF
TVS401: CG0603MLC-3.3LE; D_1608; Rating 3V3; Mouser 652-CG0603MLC-3.3LE

Connections:
+3V3: J401.10, TVS401.1 (K); also elsewhere on the board
/Hall Sensors/Sensor-1: J401.1; also elsewhere on the board
/Hall Sensors/Sensor-2: J401.2; also elsewhere on the board
/Hall Sensors/Sensor-3: J401.3; also elsewhere on the board
/Hall Sensors/Sensor-4: J401.4; also elsewhere on the board
/Hall Sensors/Sensor-5: J401.5; also elsewhere on the board
/Hall Sensors/Sensor-6: J401.6; also elsewhere on the board
/Hall Sensors/Sensor-7: J401.7; also elsewhere on the board
/Hall Sensors/Sensor-8: J401.8; also elsewhere on the board
GND: J401.9, TVS401.2 (A); also elsewhere on the board

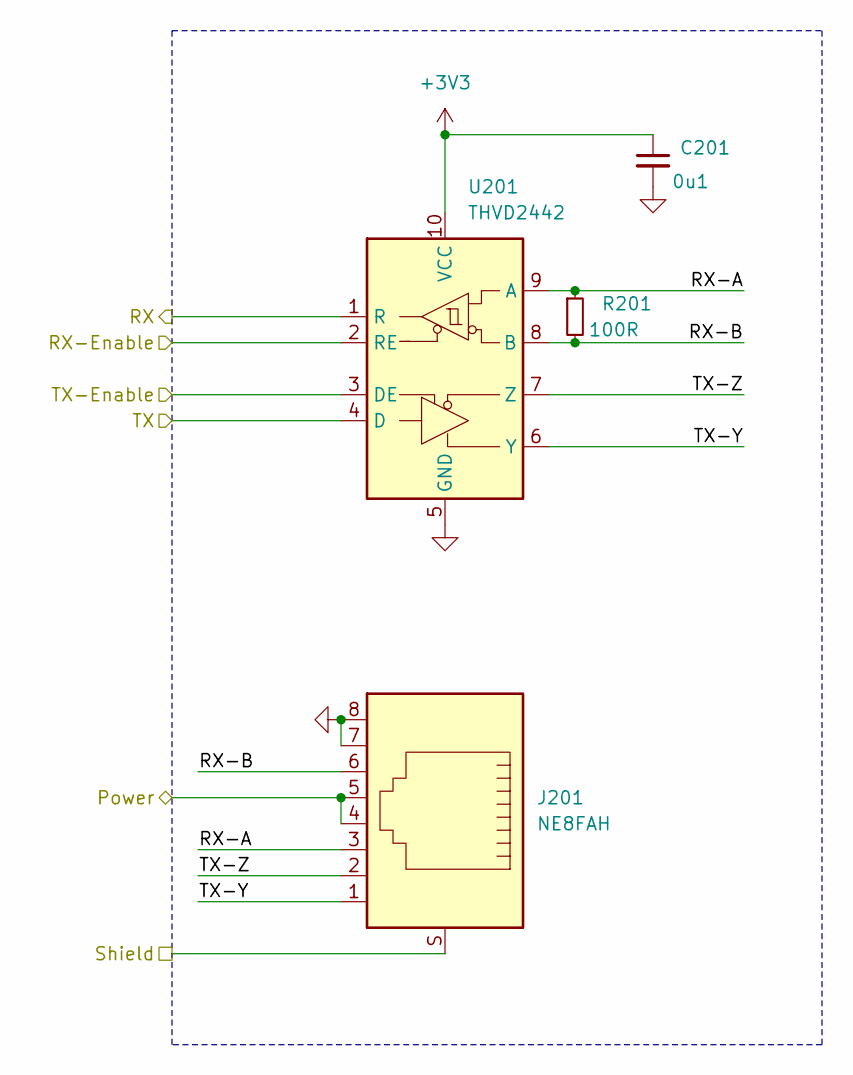
[picture p23: schematic LinkPlug.kicad_sch, V2 sax]

Parts:
C201: 0u1; C_1608; Rating 50V; Mouser 810-CGA3E2X7R1H104MA
J201: NE8FAH; Rating CAT5e; Mouser 568-NE8FAH
R201: 100R; R_1608; Rating 330mW; Mouser 71-CRCW0603100RFKEAH
U201: THVD2442; VSON-10-4-1EP_3x3mm_P0.5mm_EP1.65x2.4mm_ThermalVias; Rating 20Mbps; Mouser 595-THVD2442DRCR

Connections:
+3V3: C201.1, U201.10 (VCC); also elsewhere on the board
/+VLINK: J201.4, J201.5; also elsewhere on the board
/Link Plug/RX-A: J201.3, R201.1, U201.9 (A)
/Link Plug/RX-B: J201.6, R201.2, U201.8 (B)
/Link Plug/Shield: J201.S
/Link Plug/TX-Y: J201.1, U201.6 (Y)
/Link Plug/TX-Z: J201.2, U201.7 (Z)
/Plug-RX: U201.1 (R); also elsewhere on the board
/Plug-TX: U201.4 (D); also elsewhere on the board
/Plug-TX-Enable: U201.3 (DE); also elsewhere on the board
GND: C201.2, J201.7, J201.8, U201.2 (RE), U201.5 (GND), U201.11 (GND); also elsewhere on the board

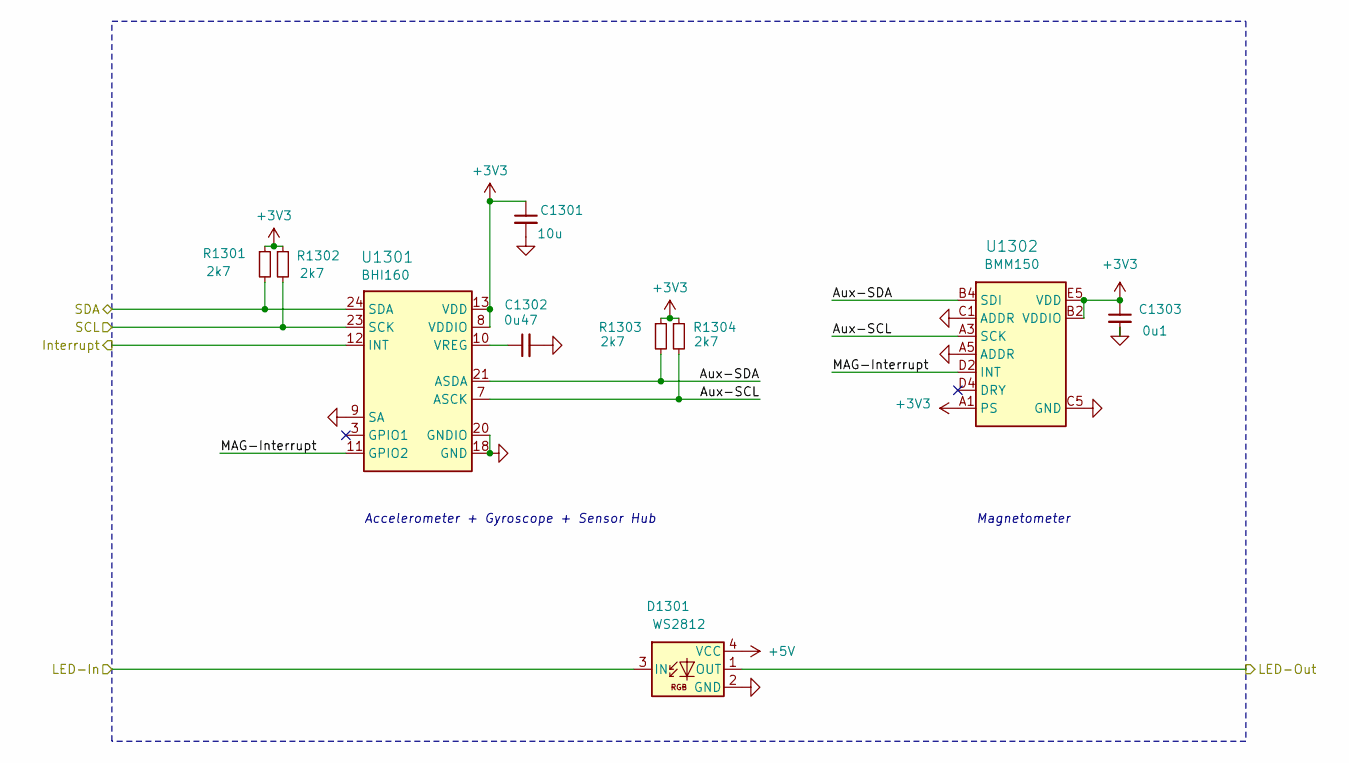
[picture p24: schematic OrientationSensor.kicad_sch, V2 sax]

Parts:
C1301: 10u; C_1608; Rating 10V; Mouser 810-C1608X6S1A106M
C1302: 0u47; C_1608; Rating 50V; Mouser 810-CGA3E3X7R1H474KB
C1303: 0u1; C_1608; Rating 50V; Mouser 810-CGA3E2X7R1H104MA
D1301: WS2812; WS2812-2020; Rating 15mA; LCSC C965555
R1301, R1302, R1303, R1304: 2k7; R_1608; Rating 100mW; Mouser 71-CRCW06032K70FKEAC
U1301: BHI160; LGA24-3x3; LCSC C464452
U1302: BMM150; WLCSP-1.56x1.56; LCSC C171681

Connections:
+3V3: C1301.1, C1303.1, R1301.1, R1302.1, R1303.1, R1304.1, U1301.8 (VDDIO), U1301.13 (VDD), U1302.A1 (PS), U1302.B2 (VDDIO), U1302.E5 (VDD); also elsewhere on the board
+5V: D1301.4 (VCC); also elsewhere on the board
/LED-Pressure: D1301.1 (OUT); also elsewhere on the board
/LED-Sensor: D1301.3 (IN); also elsewhere on the board
/Orientation Sensor/Aux-SCL: R1304.2, U1301.7 (ASCK), U1302.A3 (SCK)
/Orientation Sensor/Aux-SDA: R1303.2, U1301.21 (ASDA), U1302.B4 (SDI)
/Orientation Sensor/MAG-Interrupt: U1301.11 (GPIO2), U1302.D2 (INT)
/Orientation-Interrupt: U1301.12 (INT); also elsewhere on the board
/SCL: R1302.2, U1301.23 (SCK); also elsewhere on the board
/SDA: R1301.2, U1301.24 (SDA); also elsewhere on the board
GND: C1301.2, C1302.2, C1303.2, D1301.2 (GND), U1301.9 (SA), U1301.18 (GND), U1301.20 (GNDIO), U1302.A5 (ADDR), U1302.C1 (ADDR), U1302.C5 (GND), U1302.E1 (GND), U1302.E3 (GND); also elsewhere on the board
unnamed: C1302.1, U1301.10 (VREG)

Notes on the sheet:
Accelerometer + Gyroscope + Sensor Hub
Magnetometer

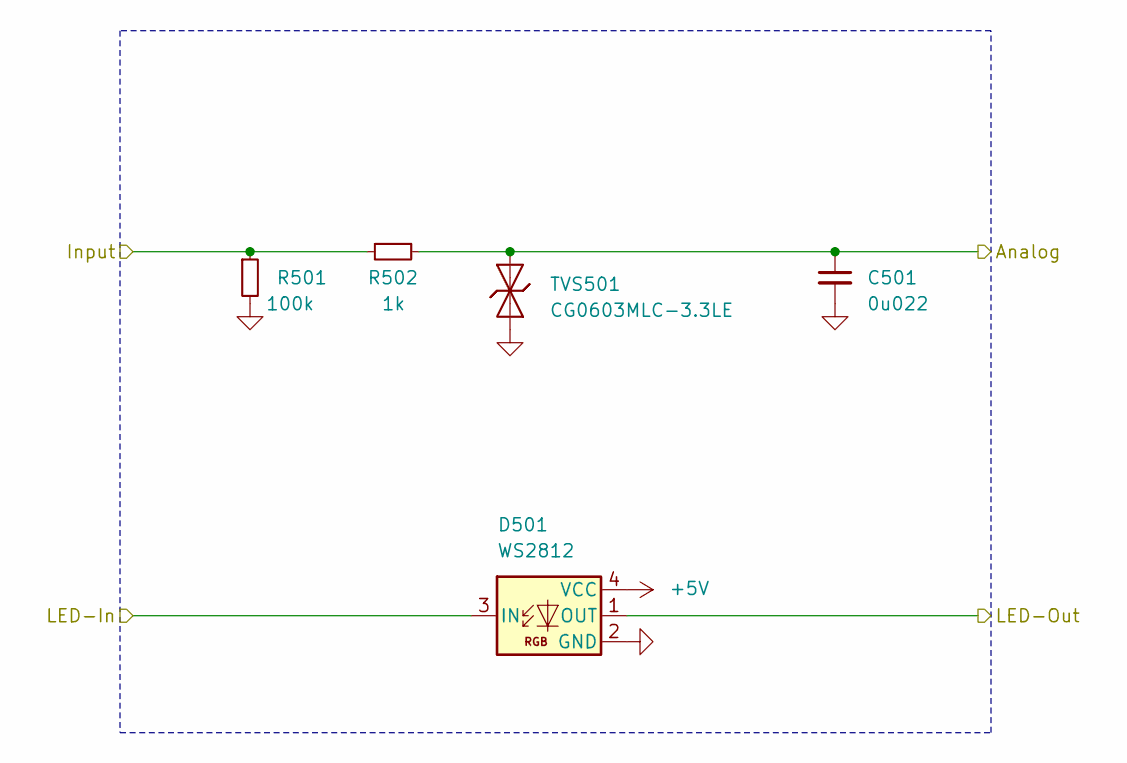
[picture p25: schematic ExpressionInput.kicad_sch, V2 sax]

Parts:
C501: 0u022; C_1608; Rating 50V; Mouser 603-CC603KPX7R9BB223
D501: WS2812; WS2812-2020; Rating 15mA; LCSC C965555
R501: 100k; R_1608; Rating 100mW; Mouser 71-CRCW0603100KFKEAC
R502: 1k; R_1608; Rating 330mW; Mouser 71-CRCW06031K00FKEAH
TVS501: CG0603MLC-3.3LE; D_1608; Rating 3V3; Mouser 652-CG0603MLC-3.3LE

Connections:
+5V: D501.4 (VCC); also elsewhere on the board
/Hall Sensors/LED-2: D501.1 (OUT); also elsewhere on the board
/Hall Sensors/Sensor-1: R501.1, R502.2; also elsewhere on the board
/Hall-1: C501.1, R502.1, TVS501.2 (A); also elsewhere on the board
/LED-Hall: D501.3 (IN); also elsewhere on the board
GND: C501.2, D501.2 (GND), R501.2, TVS501.1 (K); also elsewhere on the board

Parts of its further copies:
C601, C701, C801, C901, C1001, C1101, C1201: 0u022; C_1608; Rating 50V; Mouser 603-CC603KPX7R9BB223
D601, D701, D801, D901, D1001, D1101, D1201: WS2812; WS2812-2020; Rating 15mA; LCSC C965555
R601, R701, R801, R901, R1001, R1101, R1201: 100k; R_1608; Rating 100mW; Mouser 71-CRCW0603100KFKEAC
R602, R702, R802, R902, R1002, R1102, R1202: 1k; R_1608; Rating 330mW; Mouser 71-CRCW06031K00FKEAH
TVS601, TVS701, TVS801, TVS901, TVS1001, TVS1101, TVS1201: CG0603MLC-3.3LE; D_1608; Rating 3V3; Mouser 652-CG0603MLC-3.3LE

Connections of its further copies:
+5V: D601.4 (VCC), D701.4 (VCC), D801.4 (VCC), D901.4 (VCC), D1001.4 (VCC), D1101.4 (VCC), D1201.4 (VCC); also elsewhere on the board
/Hall Sensors/LED-2: D601.3 (IN); also elsewhere on the board
/Hall Sensors/LED-3: D601.1 (OUT), D701.3 (IN)
/Hall Sensors/LED-4: D701.1 (OUT), D801.3 (IN)
/Hall Sensors/LED-5: D801.1 (OUT), D901.3 (IN)
/Hall Sensors/LED-6: D901.1 (OUT), D1001.3 (IN)
/Hall Sensors/LED-7: D1001.1 (OUT), D1101.3 (IN)
/Hall Sensors/LED-8: D1101.1 (OUT), D1201.3 (IN)
/Hall Sensors/LED-Out: D1201.1 (OUT)
/Hall Sensors/Sensor-2: R601.1, R602.2; also elsewhere on the board
/Hall Sensors/Sensor-3: R701.1, R702.2; also elsewhere on the board
/Hall Sensors/Sensor-4: R801.1, R802.2; also elsewhere on the board
/Hall Sensors/Sensor-5: R901.1, R902.2; also elsewhere on the board
/Hall Sensors/Sensor-6: R1001.1, R1002.2; also elsewhere on the board
/Hall Sensors/Sensor-7: R1101.1, R1102.2; also elsewhere on the board
/Hall Sensors/Sensor-8: R1201.1, R1202.2; also elsewhere on the board
/Hall-2: C601.1, R602.1, TVS601.2 (A); also elsewhere on the board
/Hall-3: C701.1, R702.1, TVS701.2 (A); also elsewhere on the board
/Hall-4: C801.1, R802.1, TVS801.2 (A); also elsewhere on the board
/Hall-5: C901.1, R902.1, TVS901.2 (A); also elsewhere on the board
/Hall-6: C1001.1, R1002.1, TVS1001.2 (A); also elsewhere on the board
/Hall-7: C1101.1, R1102.1, TVS1101.2 (A); also elsewhere on the board
/Hall-8: C1201.1, R1202.1, TVS1201.2 (A); also elsewhere on the board
GND: C601.2, C701.2, C801.2, C901.2, C1001.2, C1101.2, C1201.2, D601.2 (GND), D701.2 (GND), D801.2 (GND), D901.2 (GND), D1001.2 (GND), D1101.2 (GND), D1201.2 (GND), R601.2, R701.2, R801.2, R901.2, R1001.2, R1101.2, R1201.2, TVS601.1 (K), TVS701.1 (K), TVS801.1 (K), TVS901.1 (K), TVS1001.1 (K), TVS1101.1 (K), TVS1201.1 (K); also elsewhere on the board

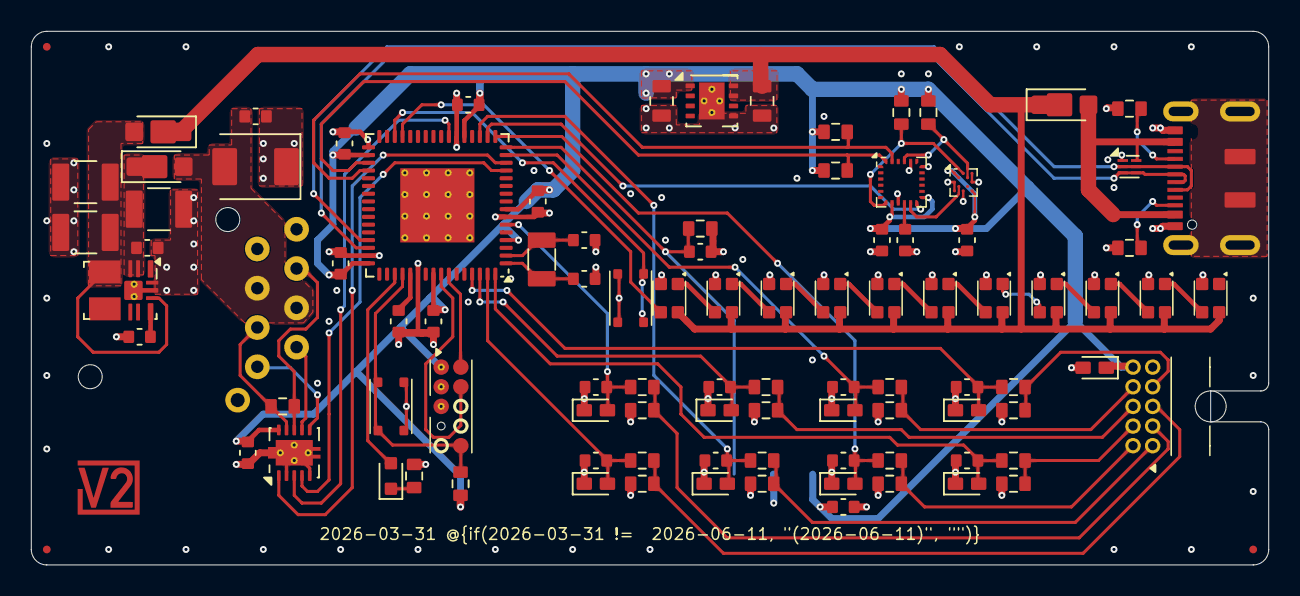
[picture p26: board sax.kicad_pcb from above]

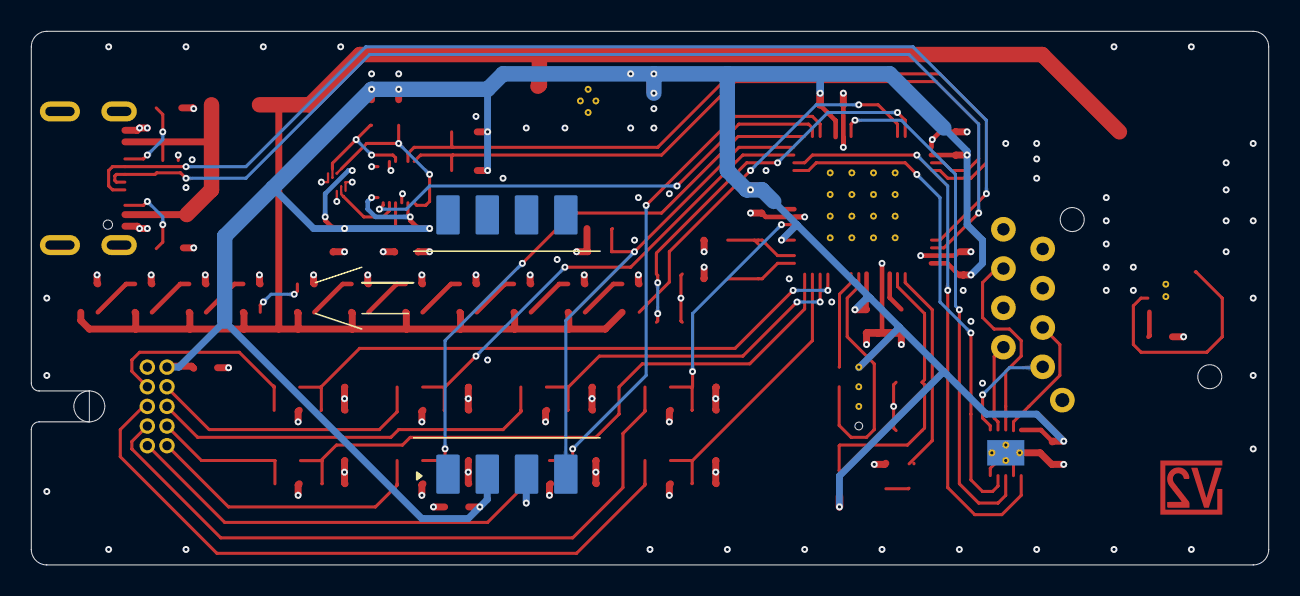
[picture p27: board sax.kicad_pcb from below]

Board: 4 copper layers, 80.0 x 34.5 mm, 103 parts (2 on the bottom side), 63 nets.
