versioduo/sax/hardware/sensor-1/sensor-1.kicad_pcb

## KiCad design hardware/sensor-1/sensor-1.kicad_pcb (2026-04-16)

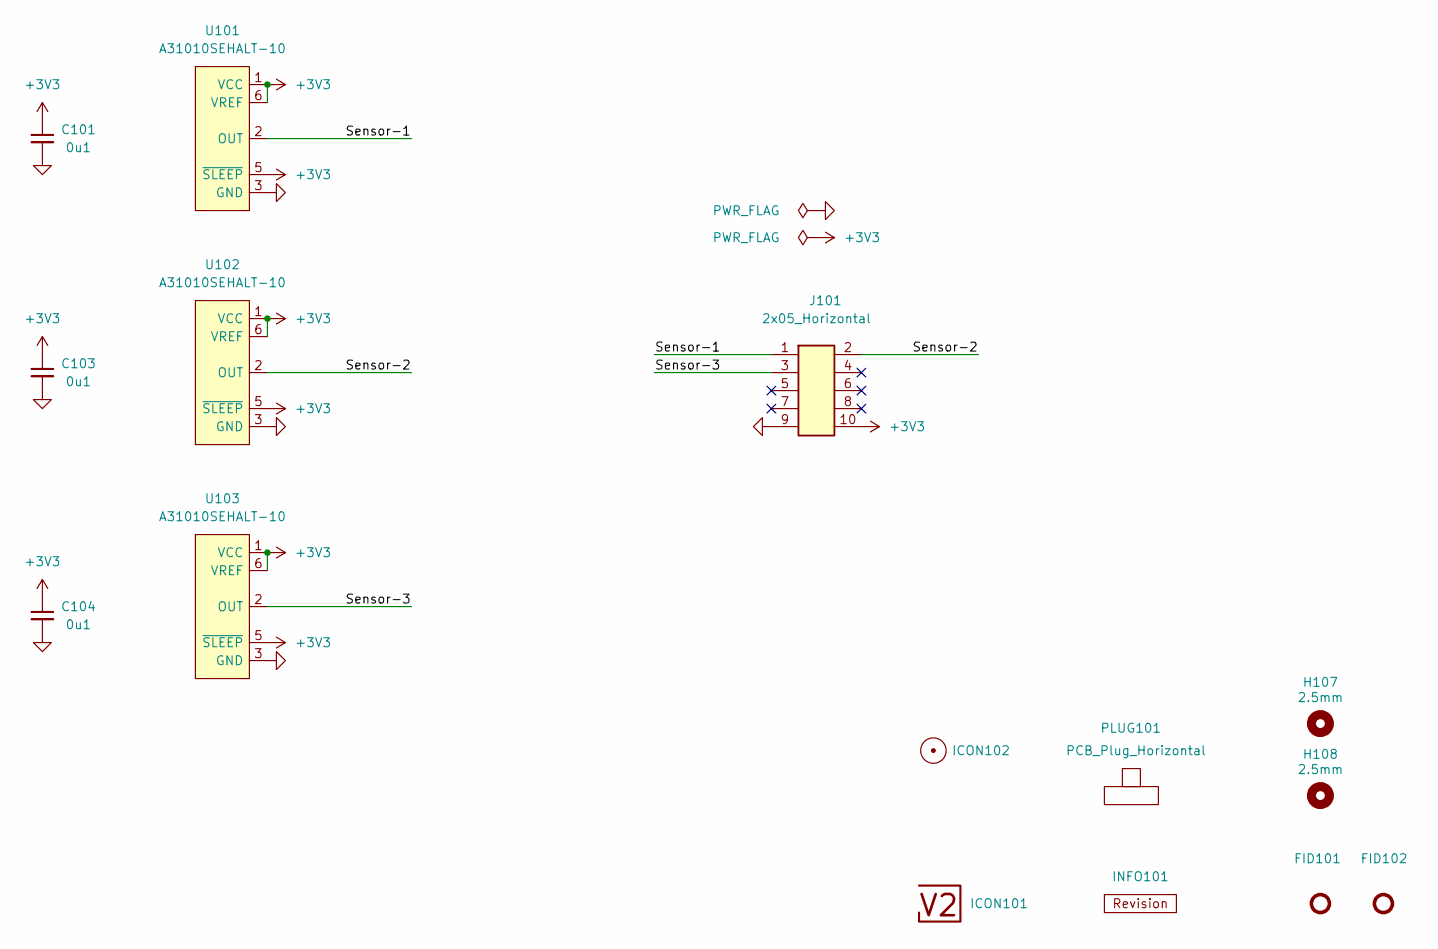
[picture p28: schematic sensor-1.kicad_sch, V2 sax]

Parts:
C101, C103, C104: 0u1; C_0603; Rating 50V; Mouser 810-CGA3E2X7R1H104MA
FID101, FID102: Fiducial_Paste; Fiducial_0.5mm_Mask1mm_Paste
H107, H108: 2.5mm; MountingHole_2.5mm
ICON101: V2-logo; Logo_Small
ICON102: Dot; Dot_Small
INFO101: Revision
J101: 2x05_Horizontal; PinHeader_2x05_P1.27mm_Horizontal; Rating 1A; Mouser 649-200211120001T4LF
PLUG101: PCB_Plug_Horizontal
U101, U102, U103: A31010SEHALT-10; A31010SEHALT10; Rating 10mV/G; Mouser 250-A31010SEHALT-10

Connections:
+3V3: C101.1, C103.1, C104.1, J101.10, U101.1 (VCC), U101.5 (~SLEEP), U101.6 (VREF), U102.1 (VCC), U102.5 (~SLEEP), U102.6 (VREF), U103.1 (VCC), U103.5 (~SLEEP), U103.6 (VREF)
/Sensor-1: J101.1, U101.2 (OUT)
/Sensor-2: J101.2, U102.2 (OUT)
/Sensor-3: J101.3, U103.2 (OUT)
GND: C101.2, C103.2, C104.2, J101.9, U101.3 (GND), U102.3 (GND), U103.3 (GND)

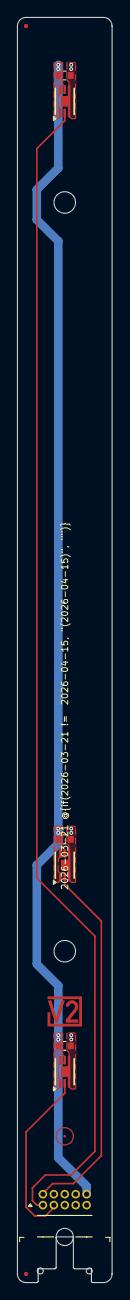
[picture p29: board sensor-1.kicad_pcb from above]

Board: 2 copper layers, 11.0 x 147.0 mm, 15 parts (0 on the bottom side), 5 nets.
