versioduo/sax/hardware/sensor-4/sensor-4.kicad_pcb

## KiCad design hardware/sensor-4/sensor-4.kicad_pcb (2026-03-22)

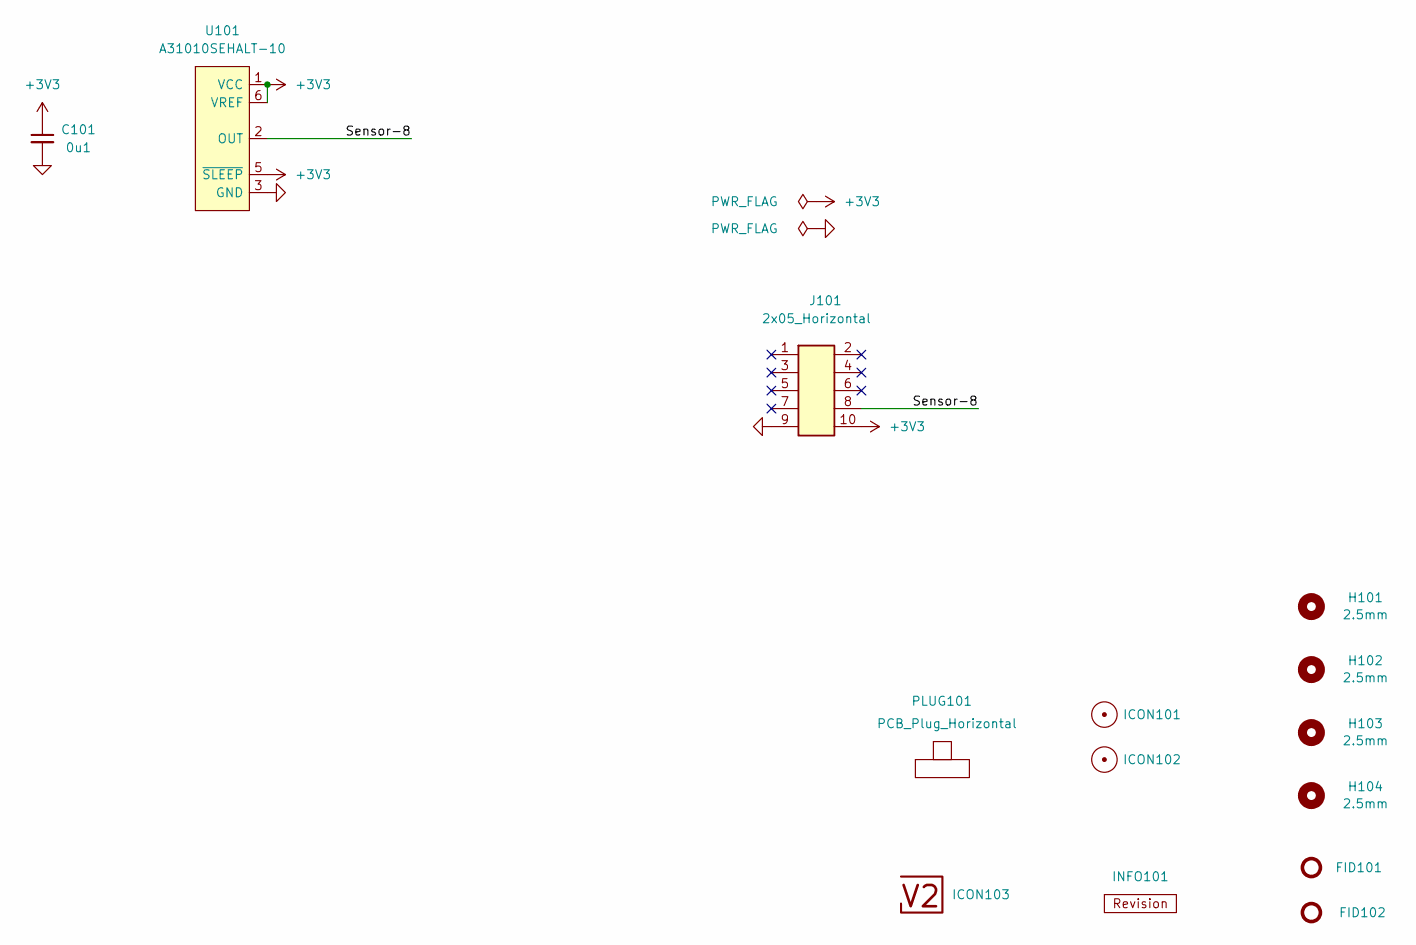
[picture p30: schematic sensor-4.kicad_sch, V2 sax]

Parts:
C101: 0u1; C_0603; Rating 50V; Mouser 810-CGA3E2X7R1H104MA
FID101, FID102: Fiducial_Paste; Fiducial_0.5mm_Mask1mm_Paste
H101, H102, H103, H104: 2.5mm; MountingHole_2.5mm
ICON101, ICON102: Dot; Dot_Small
ICON103: V2-logo; Logo_Small
INFO101: Revision
J101: 2x05_Horizontal; PinHeader_2x05_P1.27mm_Horizontal; Mouser 649-200211120001T4LF
PLUG101: PCB_Plug_Horizontal
U101: A31010SEHALT-10; A31010SEHALT10; Mouser 250-A31010SEHALT-10

Connections:
+3V3: C101.1, J101.10, U101.1 (VCC), U101.5 (~SLEEP), U101.6 (VREF)
/Sensor-8: J101.8, U101.2 (OUT)
GND: C101.2, J101.9, U101.3 (GND)

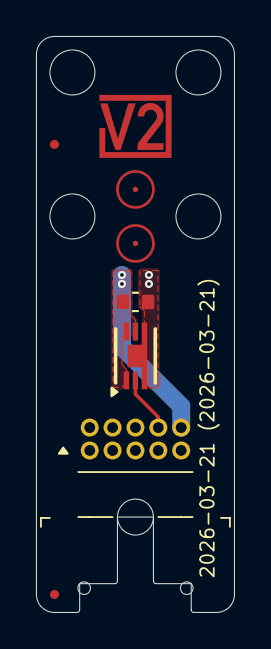
[picture p31: board sensor-4.kicad_pcb from above]

Board: 2 copper layers, 11.0 x 32.0 mm, 14 parts (0 on the bottom side), 3 nets.
