versioduo/sax/(commit log)

2025-12-31 Add sax euro
    [AnalogSensors.kicad_sch, ExpressionInput.kicad_sch, LinkPlug.kicad_sch, MIDIOut.kicad_sch, OrientationSensor.kicad_sch, PowerSupply.kicad_sch, euro.kicad_pcb, euro.kicad_sch]
2026-01-15 Update library
    [AnalogSensors.kicad_sch, ExpressionInput.kicad_sch, LinkPlug.kicad_sch, OrientationSensor.kicad_sch, PowerSupply.kicad_sch, sax.kicad_pcb, sax.kicad_sch]
2026-01-15 Add accelerometer
2026-01-19 Add sax2
    [ExpressionInput.kicad_sch, HallSensors.kicad_sch, LinkPlug.kicad_sch, OrientationSensor.kicad_sch, PowerSupply.kicad_sch, PressureSensor.kicad_sch, sax.kicad_pcb, sax2.kicad_pcb]
2026-01-22 Refresh footprints
    [ExpressionInput.kicad_sch, HallSensors.kicad_sch, LinkPlug.kicad_sch, OrientationSensor.kicad_sch, PowerSupply.kicad_sch, PressureSensor.kicad_sch, sax2.kicad_pcb, sax2.kicad_sch]
2026-01-29 Update sensors
    [sax2.kicad_pcb, sensor-1.kicad_pcb, sensor-1.kicad_sch, sensor-2.kicad_pcb, sensor-2.kicad_sch, sensor-3.kicad_pcb, sensor-3.kicad_sch]
2026-02-05 Udpate I2C
2026-02-13 Replace Order_Number
    [AnalogSensors.kicad_sch, ExpressionInput.kicad_sch, LinkPlug.kicad_sch, MIDIOut.kicad_sch, OrientationSensor.kicad_sch, PowerSupply.kicad_sch, button-laser.dxf, euro.kicad_pcb]
2026-02-20 Update note timing
    [sax2.kicad_sch]
2026-02-21 Update calibration
    [sax2.kicad_pcb]
2026-02-22 Add pressure
2026-02-22 sax2 -> sax
    [AnalogSensors.kicad_sch, ExpressionInput.kicad_sch, HallSensors.kicad_sch, LinkPlug.kicad_sch, OrientationSensor.kicad_sch, PowerSupply.kicad_sch, PressureSensor.kicad_sch, sax.kicad_pcb]
2026-02-25 Export stencil
    [sax.kicad_pcb, sax.kicad_sch, sensor-1.kicad_pcb, sensor-1.kicad_sch, sensor-2.kicad_pcb, sensor-2.kicad_sch, sensor-3.kicad_pcb, sensor-3.kicad_sch]
2026-03-14 Update ESD suppressor
    [ExpressionInput.kicad_sch, LinkPlug.kicad_sch, OrientationSensor.kicad_sch, PowerSupply.kicad_sch, PressureSensor.kicad_sch, sax.kicad_pcb, sax.kicad_sch]
2026-03-16 Remap pressure
2026-03-22 KiCad 10
    [ExpressionInput.kicad_sch, HallSensors.kicad_sch, LinkPlug.kicad_sch, OrientationSensor.kicad_sch, PowerSupply.kicad_sch, PressureSensor.kicad_sch, sax.kicad_pcb, sax.kicad_sch]
2026-03-23 Update calibration logic
2026-03-26 Update connect
    [sax.kicad_pcb]
2026-03-29 Update Revision footprint
    [sax.kicad_pcb, sensor-1.kicad_pcb, sensor-2.kicad_pcb]
2026-03-31 Replace step-down
    [ExpressionInput.kicad_sch, HallSensors.kicad_sch, LinkPlug.kicad_sch, OrientationSensor.kicad_sch, PowerSupply.kicad_sch, PressureSensor.kicad_sch, sax.kicad_pcb, sax.kicad_sch]
2026-04-04 Limit up note length to 3 seconds
    [ExpressionInput.kicad_sch, HallSensors.kicad_sch, LinkPlug.kicad_sch, OrientationSensor.kicad_sch, PowerSupply.kicad_sch, PressureSensor.kicad_sch, sax.kicad_pcb, sax.kicad_sch]
2026-04-09 Disable orientation and pressure
2026-04-24 Update DRC
    [sax.kicad_pcb]
2026-05-11 Good Bye Imperial
    [ExpressionInput.kicad_sch, LinkPlug.kicad_sch, OrientationSensor.kicad_sch, PowerSupply.kicad_sch, PressureSensor.kicad_sch, sax.kicad_sch, sensor-1.kicad_sch, sensor-2.kicad_sch]
2026-08-02 Adjust minimum pressure
